DataXujing/SpotM2-Jetson/deepsocial/Images/SocialD-Violations.jpg

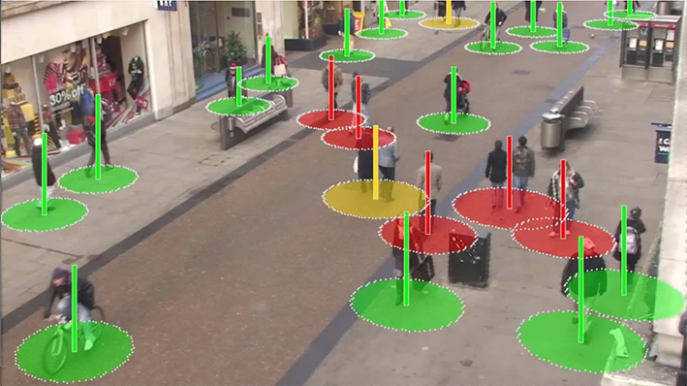
deepsocial/Images/SocialD-Violations.jpg
