DataXujing/SpotM2-Jetson/deepsocial/res/1bea7482696f88c633229da7782a3c09.jpeg

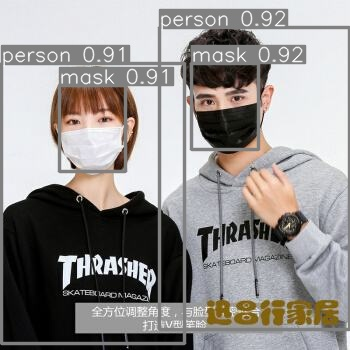
deepsocial/res/1bea7482696f88c633229da7782a3c09.jpeg
