DataXujing/SpotM2-Jetson/deepsocial/res/1e55ca499b109a8f58c59cec6625aa7d.jpeg

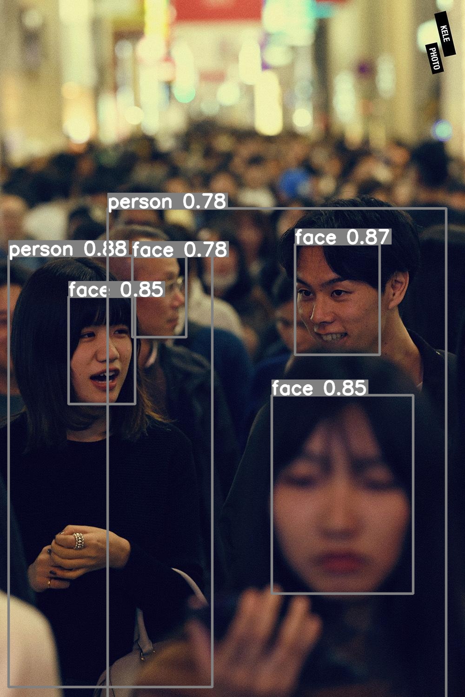
deepsocial/res/1e55ca499b109a8f58c59cec6625aa7d.jpeg
