DataXujing/SpotM2-Jetson/deepsocial/res/6f58421a69d5621d284e0617fe9576cd.jpeg

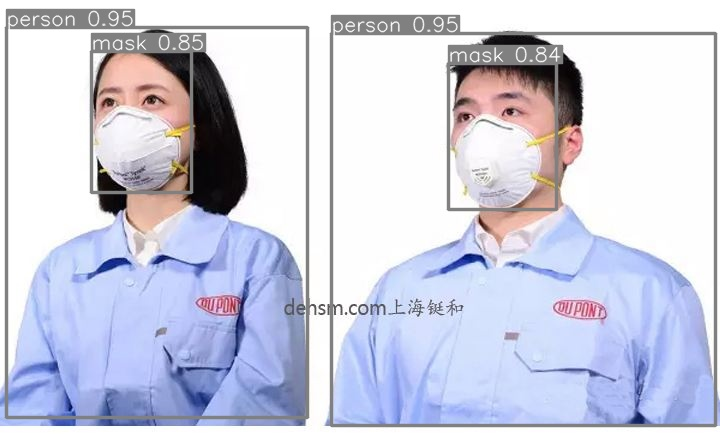
deepsocial/res/6f58421a69d5621d284e0617fe9576cd.jpeg
