DataXujing/SpotM2-Jetson/deepsocial/res/76a0da085213dce2dc654bfbd03b5c2e.jpeg

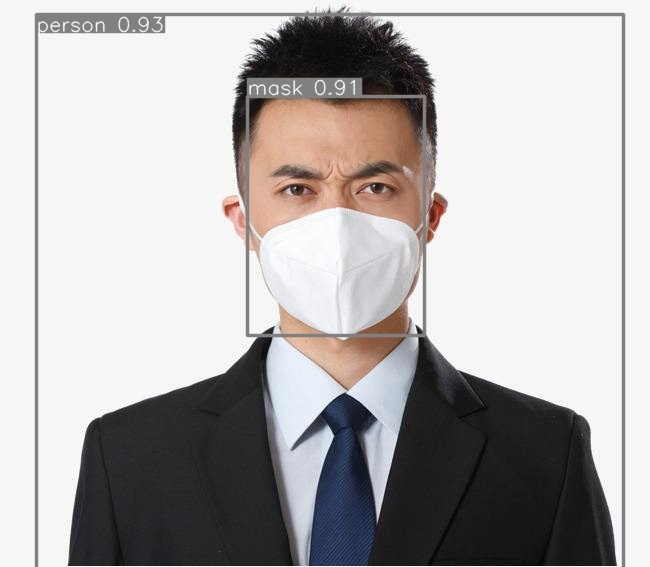
deepsocial/res/76a0da085213dce2dc654bfbd03b5c2e.jpeg
