DataXujing/SpotM2-Jetson/deepsocial/res/86e3ae728b26306a236e1a8555faf9d6.jpeg

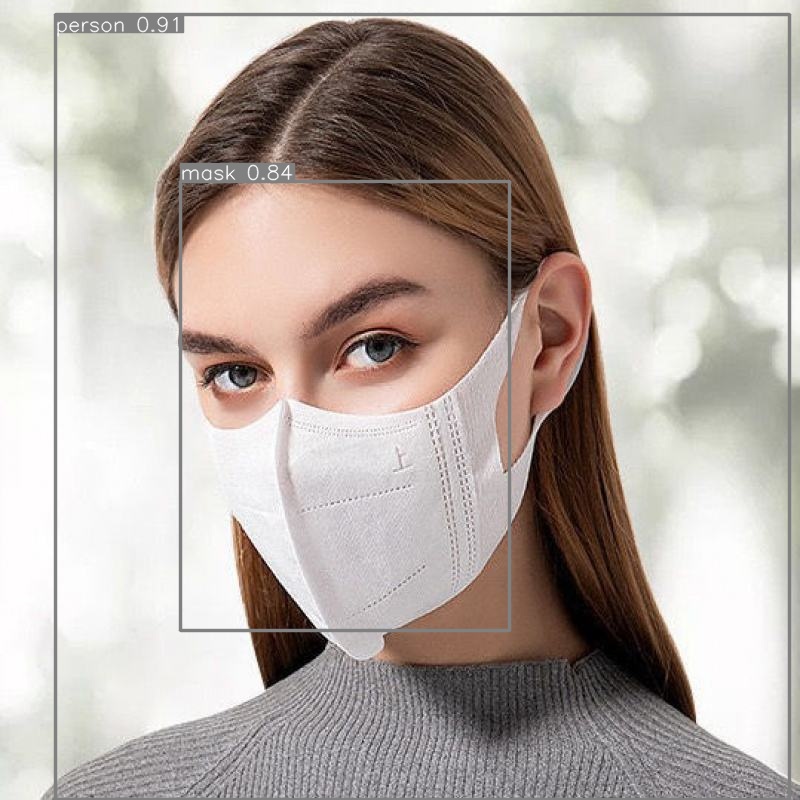
deepsocial/res/86e3ae728b26306a236e1a8555faf9d6.jpeg
