DataXujing/SpotM2-Jetson/deepsocial/res/359fc1ad313070030813128c69b127fc.jpeg

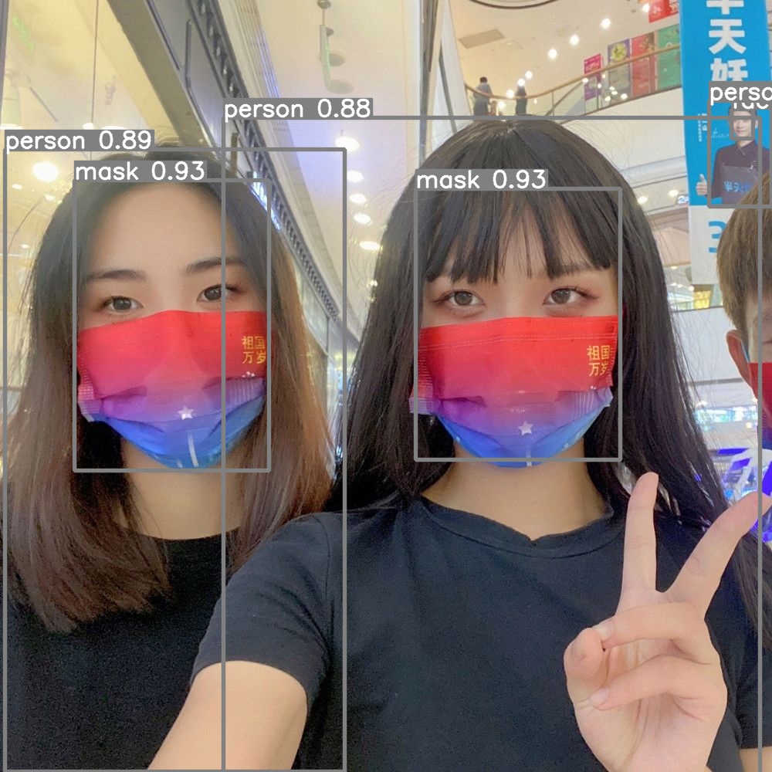
deepsocial/res/359fc1ad313070030813128c69b127fc.jpeg
