DataXujing/SpotM2-Jetson/deepsocial/res/64659bd6bf9b24c7b2e83b52e51c632e.jpeg

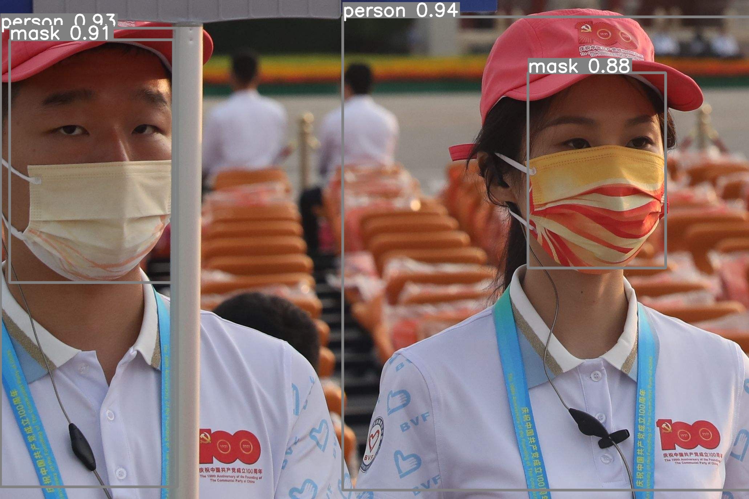
deepsocial/res/64659bd6bf9b24c7b2e83b52e51c632e.jpeg
