DataXujing/SpotM2-Jetson/deepsocial/res/a19aeec65c8fa7fa5cd013690f805bf3.jpeg

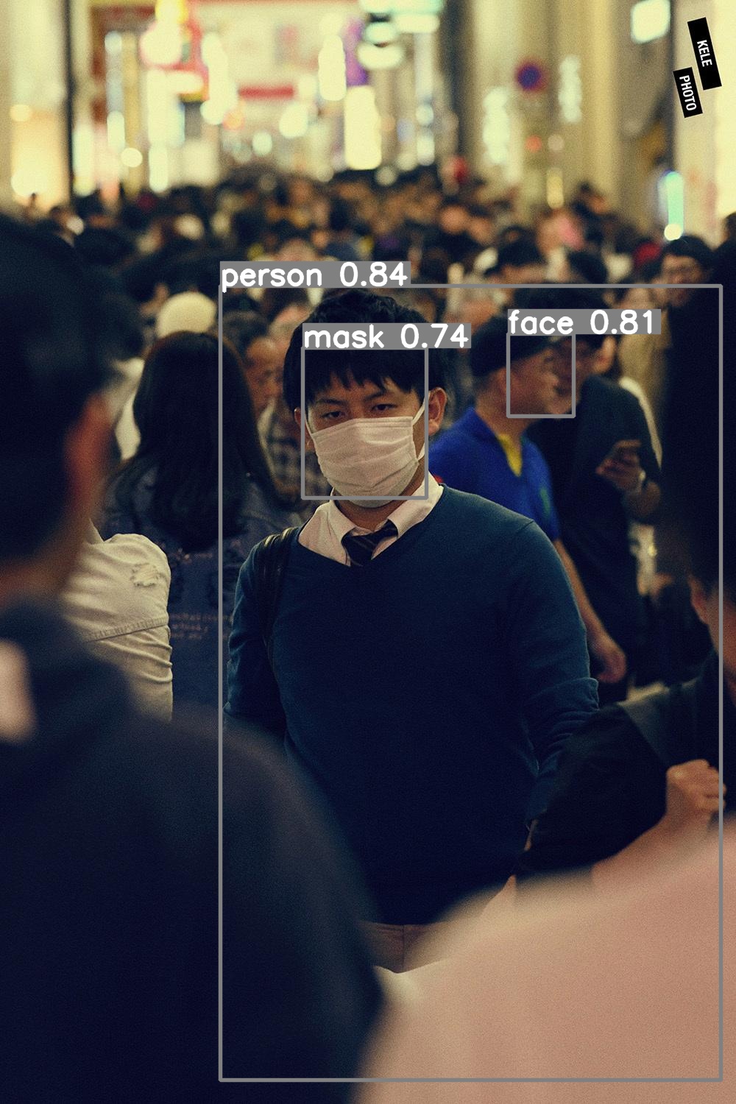
deepsocial/res/a19aeec65c8fa7fa5cd013690f805bf3.jpeg
