DataXujing/SpotM2-Jetson/deepsocial/res/b801af663609ed3e3a4c4865d9339148.jpeg

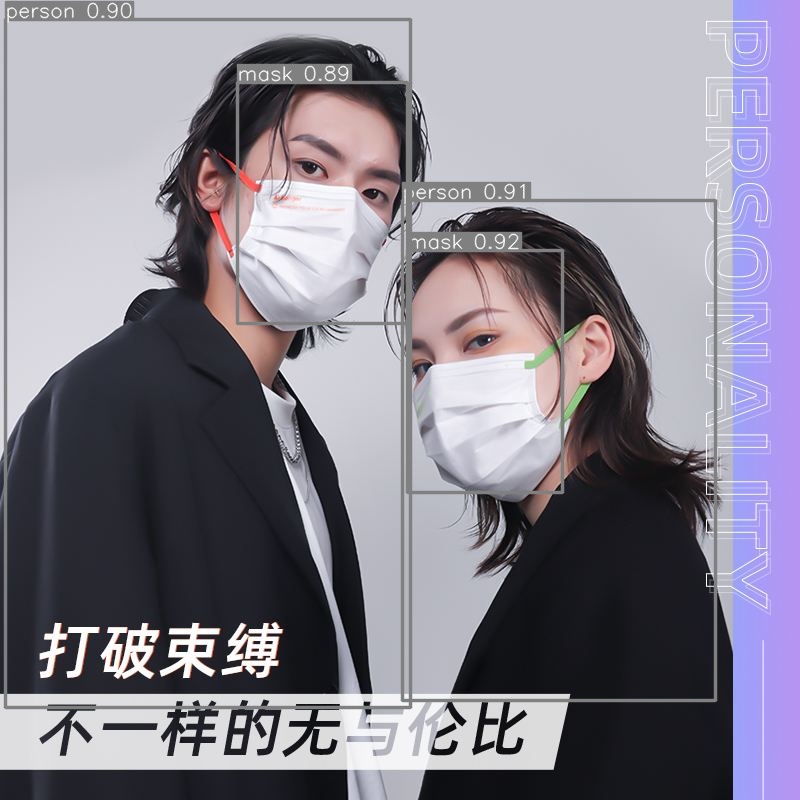
deepsocial/res/b801af663609ed3e3a4c4865d9339148.jpeg
