DataXujing/SpotM2-Jetson/deepsocial/res/d9d2d3555ee87a75234beef27a00c857.jpeg

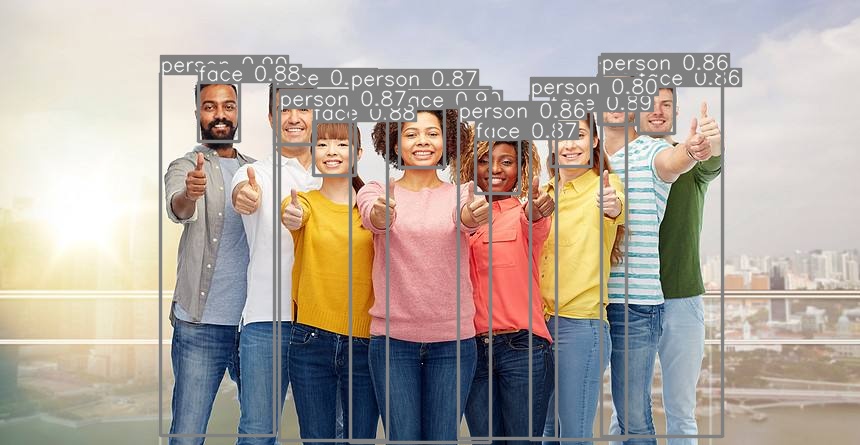
deepsocial/res/d9d2d3555ee87a75234beef27a00c857.jpeg
