DataXujing/SpotM2-Jetson/deepsocial/res/df1ec98a7be1bb21a3fbe03b773ce5f9.jpeg

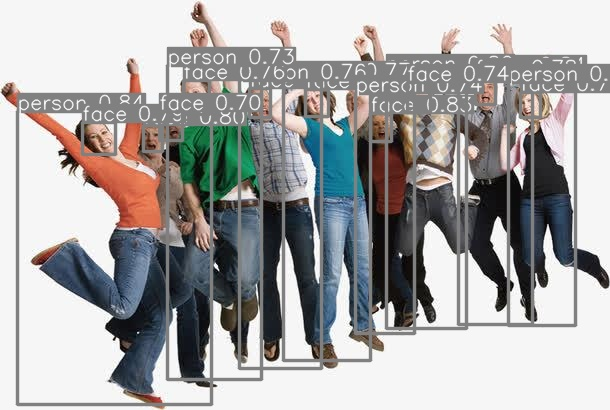
deepsocial/res/df1ec98a7be1bb21a3fbe03b773ce5f9.jpeg
