DataXujing/SpotM2-Jetson/deepsocial/res/e319a9496abcf98762bcb039ad041695.jpeg

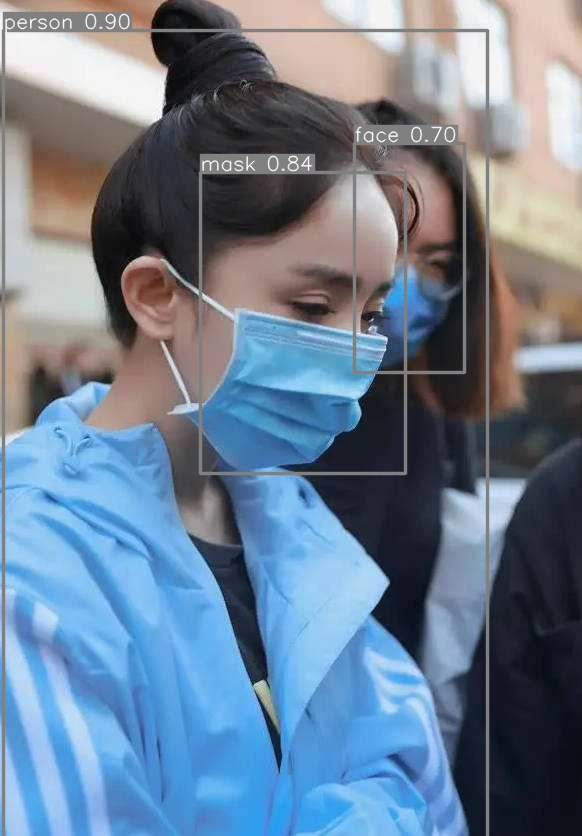
deepsocial/res/e319a9496abcf98762bcb039ad041695.jpeg
