DataXujing/SpotM2-Jetson/deepsocial/res/ed89a410d687e686057929587740cf3d.jpeg

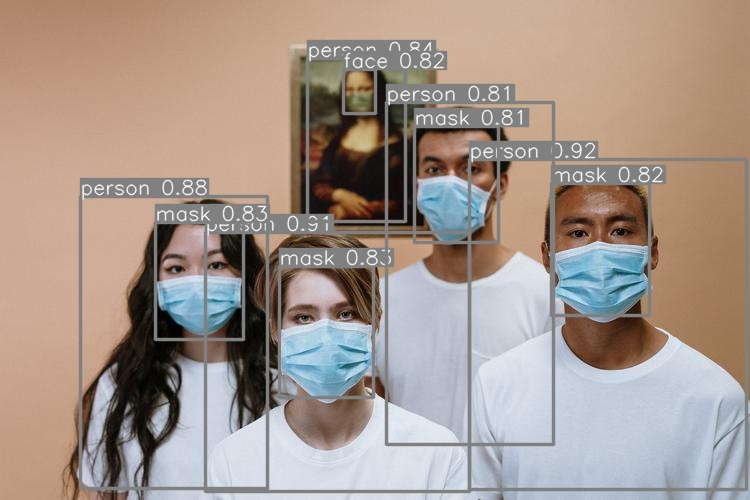
deepsocial/res/ed89a410d687e686057929587740cf3d.jpeg
