DataXujing/SpotM2-Jetson/deepsocial/res/f4e598c1ad9aae733f02a17c55224ddc.jpeg

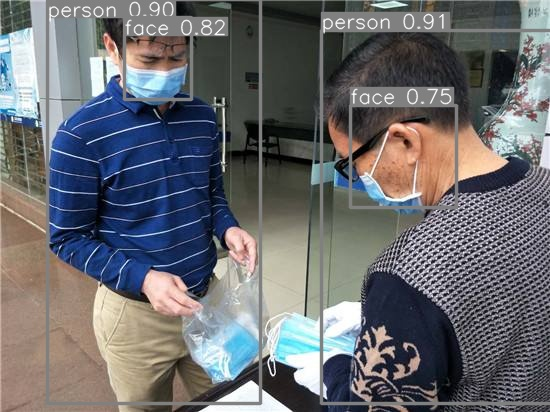
deepsocial/res/f4e598c1ad9aae733f02a17c55224ddc.jpeg
