DataXujing/SpotM2-Jetson/images/be20a860d1abb6605677f61556a89ea.jpg

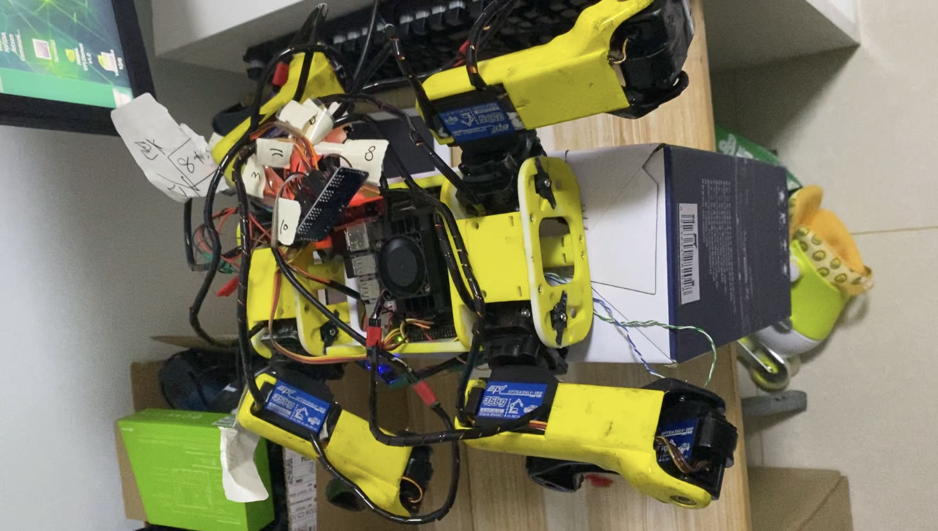
images/be20a860d1abb6605677f61556a89ea.jpg
