DataXujing/SpotM2-Jetson/spotMicro-ROS-Melodic-Jetson-Nano/assets/1_robot_right_links.png

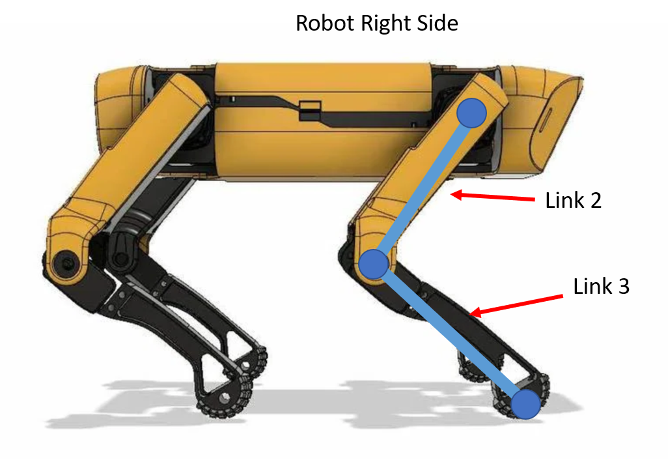
spotMicro-ROS-Melodic-Jetson-Nano/assets/1_robot_right_links.png
