DataXujing/SpotM2-Jetson/spotMicro-ROS-Melodic-Jetson-Nano/assets/2_right_straight_links.png

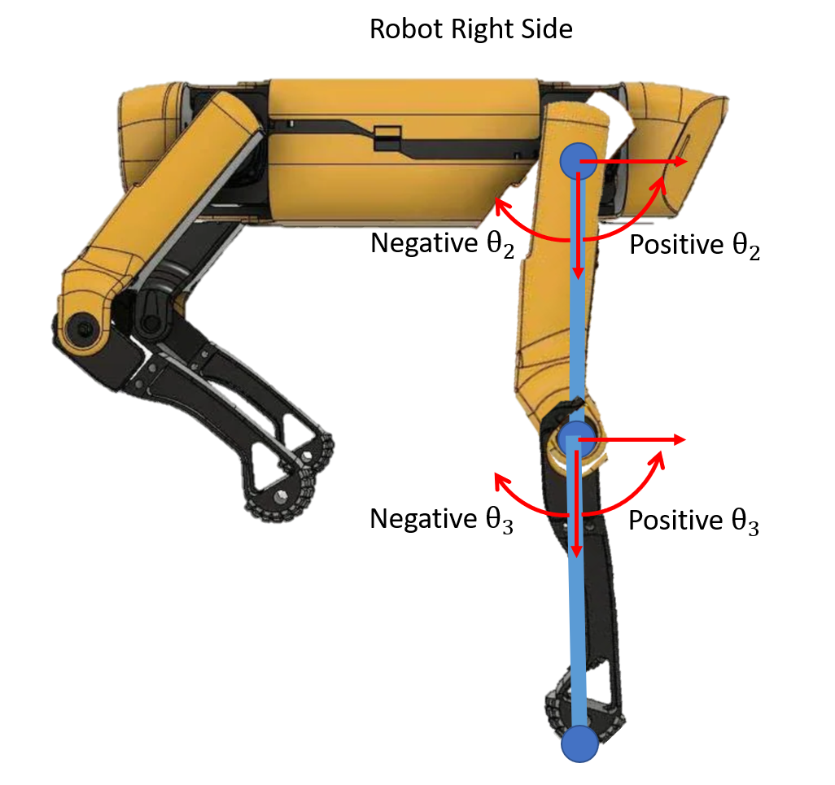
spotMicro-ROS-Melodic-Jetson-Nano/assets/2_right_straight_links.png
