DataXujing/SpotM2-Jetson/spotMicro-ROS-Melodic-Jetson-Nano/assets/3_right_link_angles_example.png

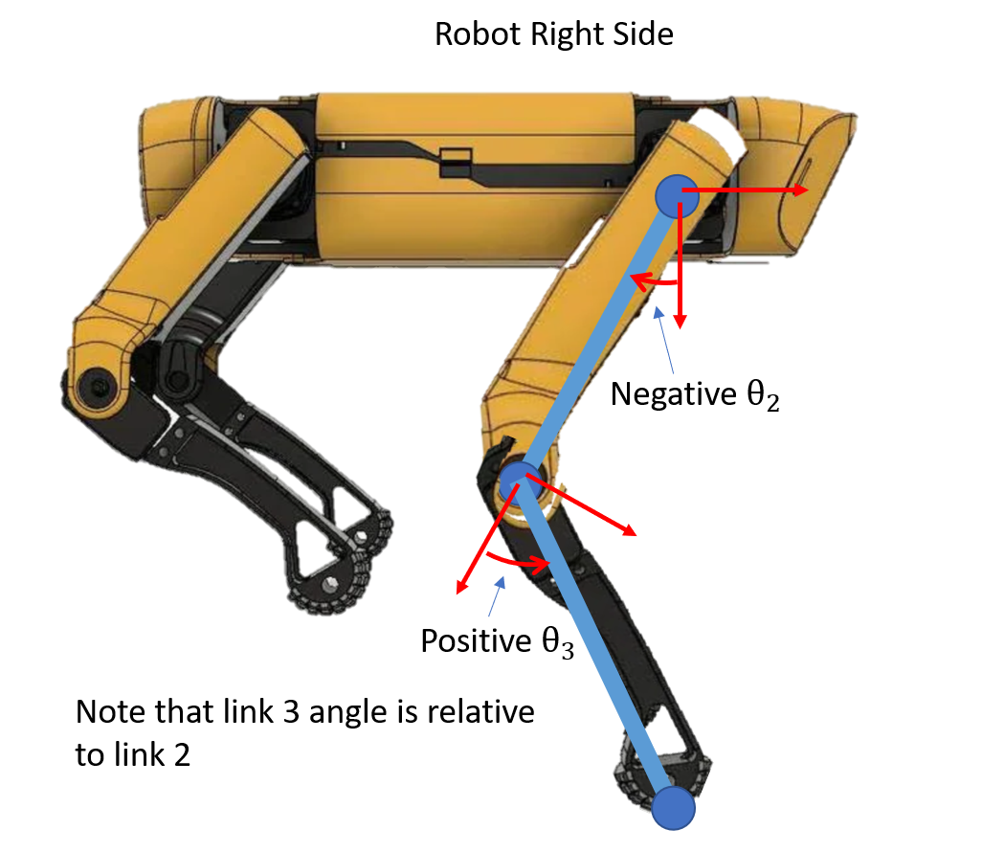
spotMicro-ROS-Melodic-Jetson-Nano/assets/3_right_link_angles_example.png
