DataXujing/SpotM2-Jetson/spotMicro-ROS-Melodic-Jetson-Nano/assets/7_robot_left_overview.png

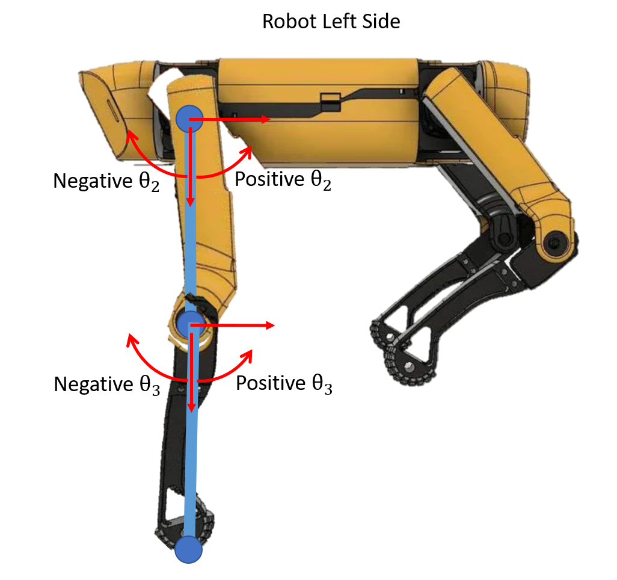
spotMicro-ROS-Melodic-Jetson-Nano/assets/7_robot_left_overview.png
