DataXujing/SpotM2-Jetson/spotMicro-ROS-Melodic-Jetson-Nano/assets/12_robot_back_overview.png

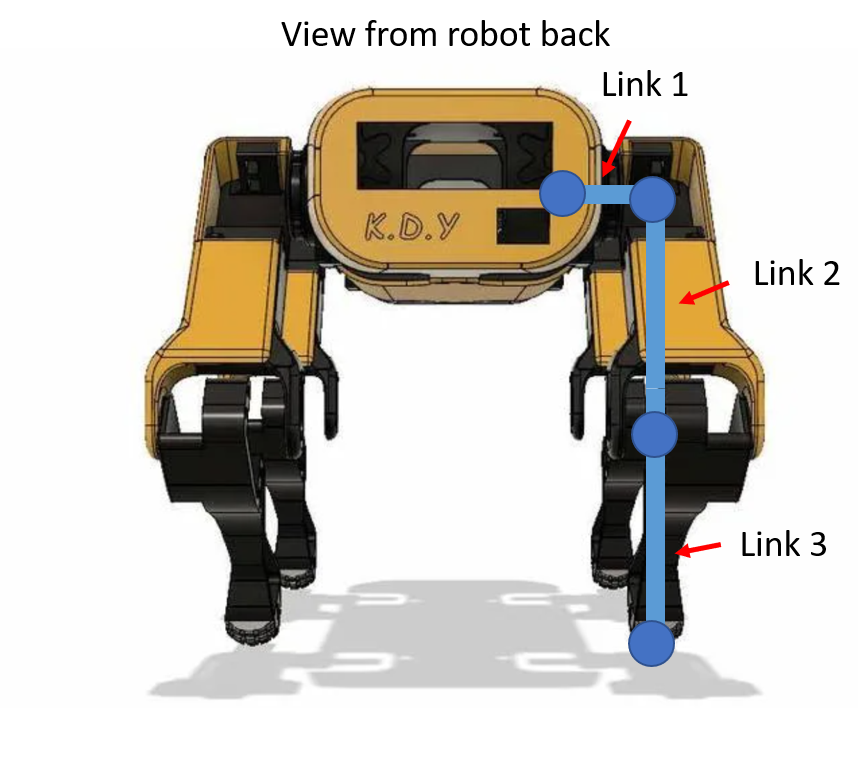
spotMicro-ROS-Melodic-Jetson-Nano/assets/12_robot_back_overview.png
