DataXujing/SpotM2-Jetson/spotMicro-ROS-Melodic-Jetson-Nano/assets/kinematic_coord_system.jpg

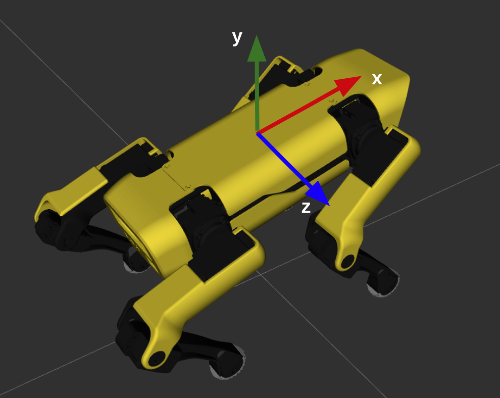
spotMicro-ROS-Melodic-Jetson-Nano/assets/kinematic_coord_system.jpg
