DataXujing/SpotM2-Jetson/spotMicro-ROS-Melodic-Jetson-Nano/assets/lidar_mount.jpg

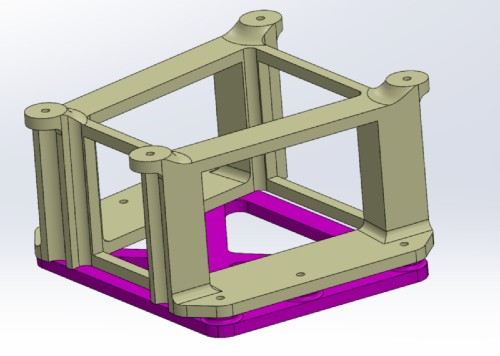
spotMicro-ROS-Melodic-Jetson-Nano/assets/lidar_mount.jpg
