DataXujing/SpotM2-Jetson/spotMicro-ROS-Melodic-Jetson-Nano/assets/robot_bottom.jpg

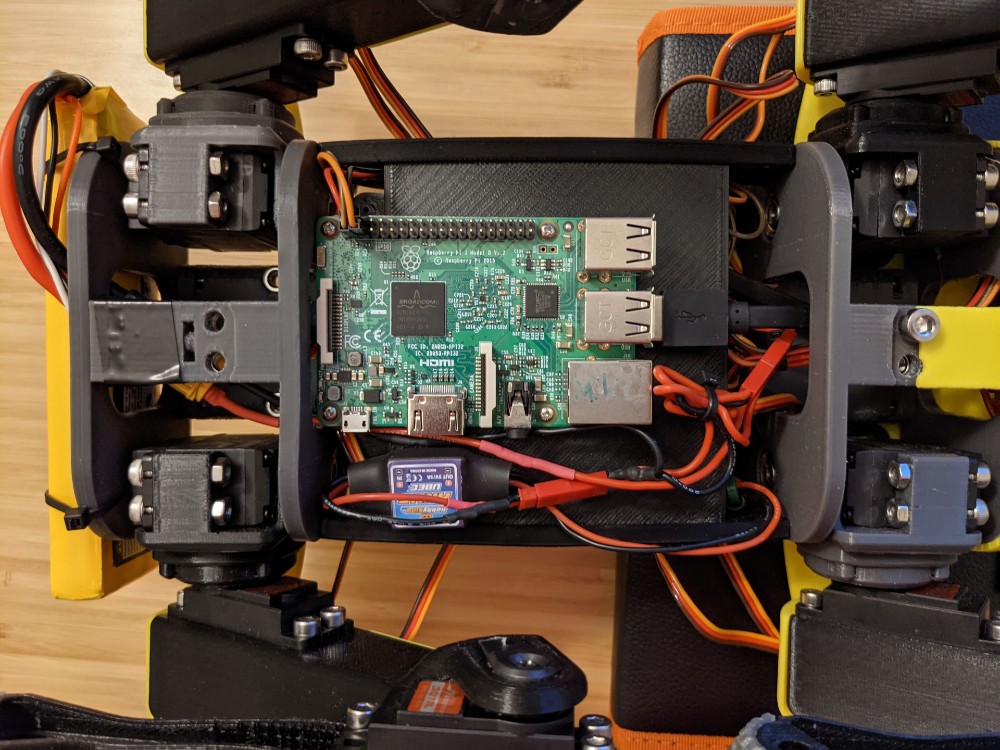
spotMicro-ROS-Melodic-Jetson-Nano/assets/robot_bottom.jpg
