DataXujing/SpotM2-Jetson/spotMicro-ROS-Melodic-Jetson-Nano/assets/robot_top.jpg

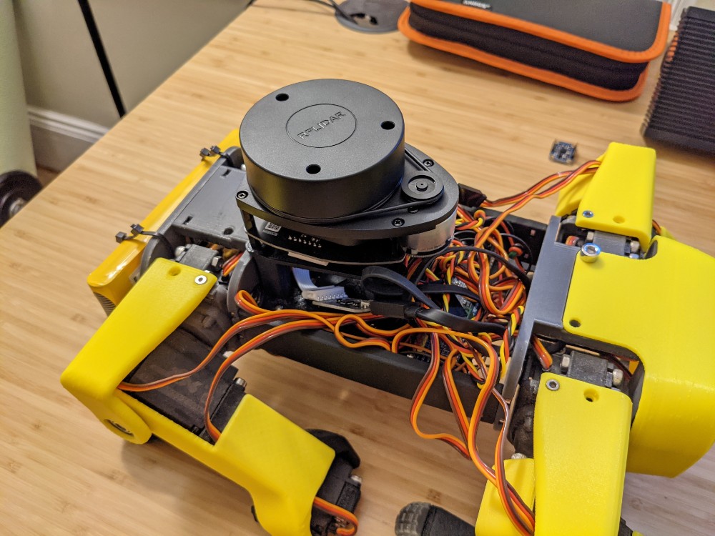
spotMicro-ROS-Melodic-Jetson-Nano/assets/robot_top.jpg
