DataXujing/SpotM2-Jetson/spotMicro-ROS-Melodic-Jetson-Nano/assets/robot_top_no_servos.jpg

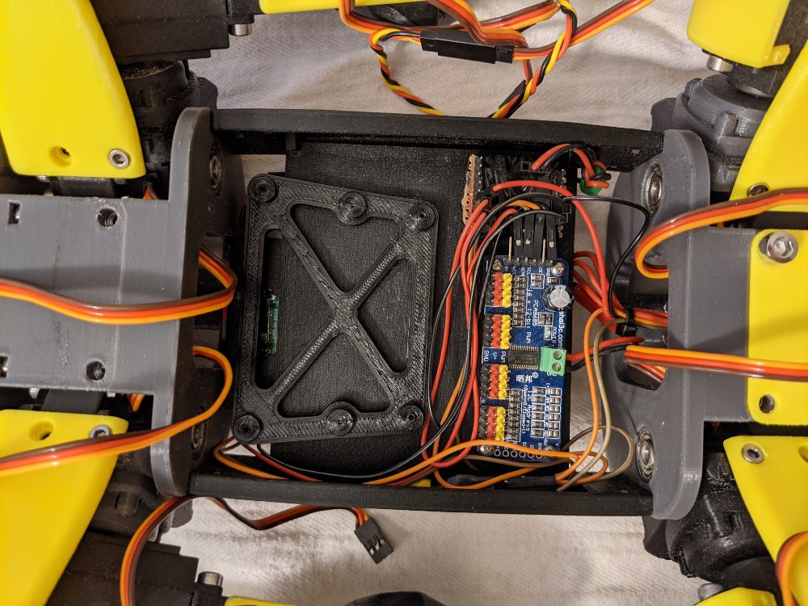
spotMicro-ROS-Melodic-Jetson-Nano/assets/robot_top_no_servos.jpg
