DataXujing/SpotM2-Jetson/spotMicro-ROS-Melodic-Jetson-Nano/assets/rpi_platform.jpg

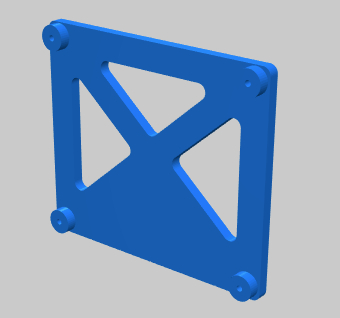
spotMicro-ROS-Melodic-Jetson-Nano/assets/rpi_platform.jpg
