DataXujing/SpotM2-Jetson/spotMicro-ROS-Melodic-Jetson-Nano/assets/rviz_animation.gif

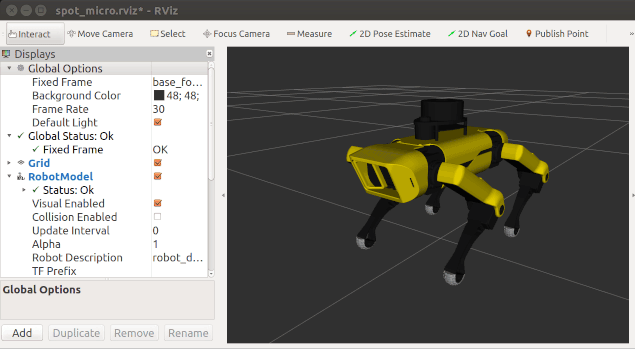
spotMicro-ROS-Melodic-Jetson-Nano/assets/rviz_animation.gif
