DataXujing/SpotM2-Jetson/spotMicro-ROS-Melodic-Jetson-Nano/assets/servo_move_prompt.png

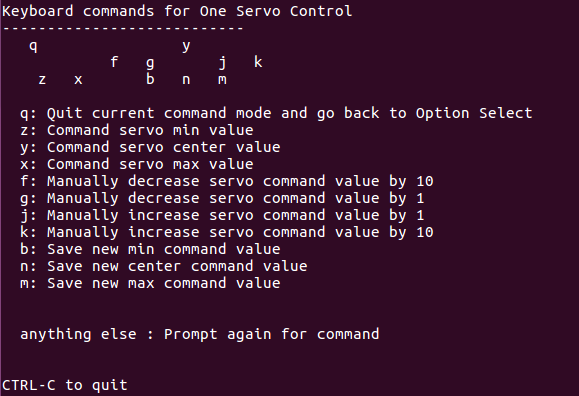
spotMicro-ROS-Melodic-Jetson-Nano/assets/servo_move_prompt.png
