DataXujing/SpotM2-Jetson/spotMicro-ROS-Melodic-Jetson-Nano/assets/spot_micro_slam.gif

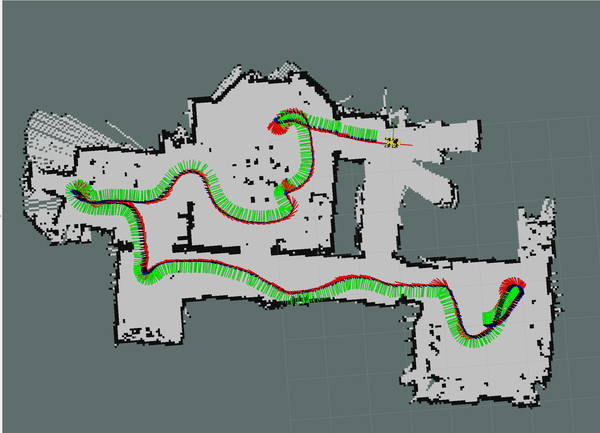
spotMicro-ROS-Melodic-Jetson-Nano/assets/spot_micro_slam.gif
