DataXujing/SpotM2-Jetson/spotMicro-ROS-Melodic-Jetson-Nano/assets/state_machine.png

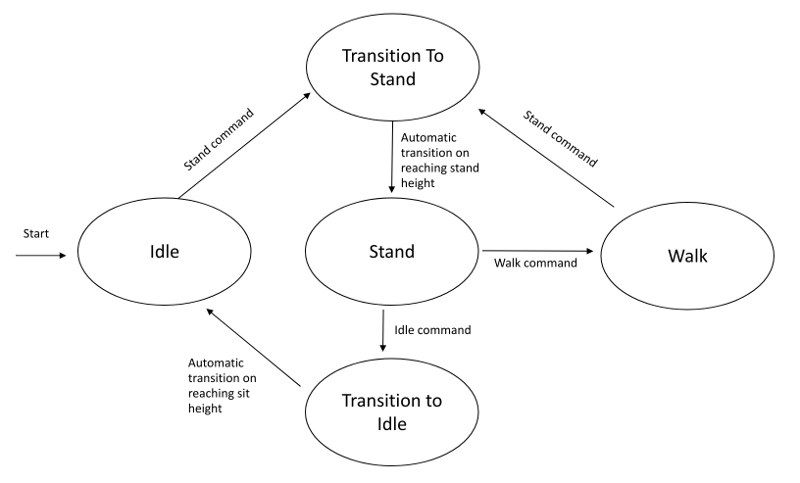
spotMicro-ROS-Melodic-Jetson-Nano/assets/state_machine.png
