DataXujing/SpotM2-Jetson/spotMicro-ROS-Melodic-Jetson-Nano/assets/tf2_coord_system.jpg

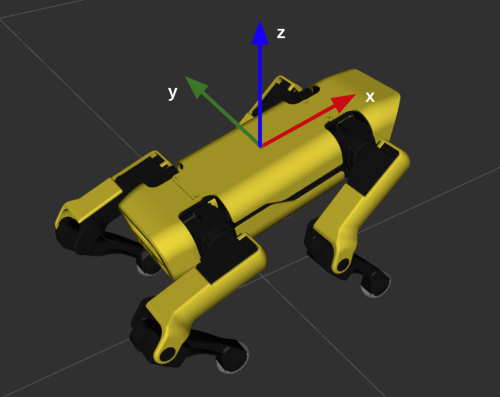
spotMicro-ROS-Melodic-Jetson-Nano/assets/tf2_coord_system.jpg
