DataXujing/SpotM2-Jetson/YOLOv6-mask/res/1e55ca499b109a8f58c59cec6625aa7d.jpeg

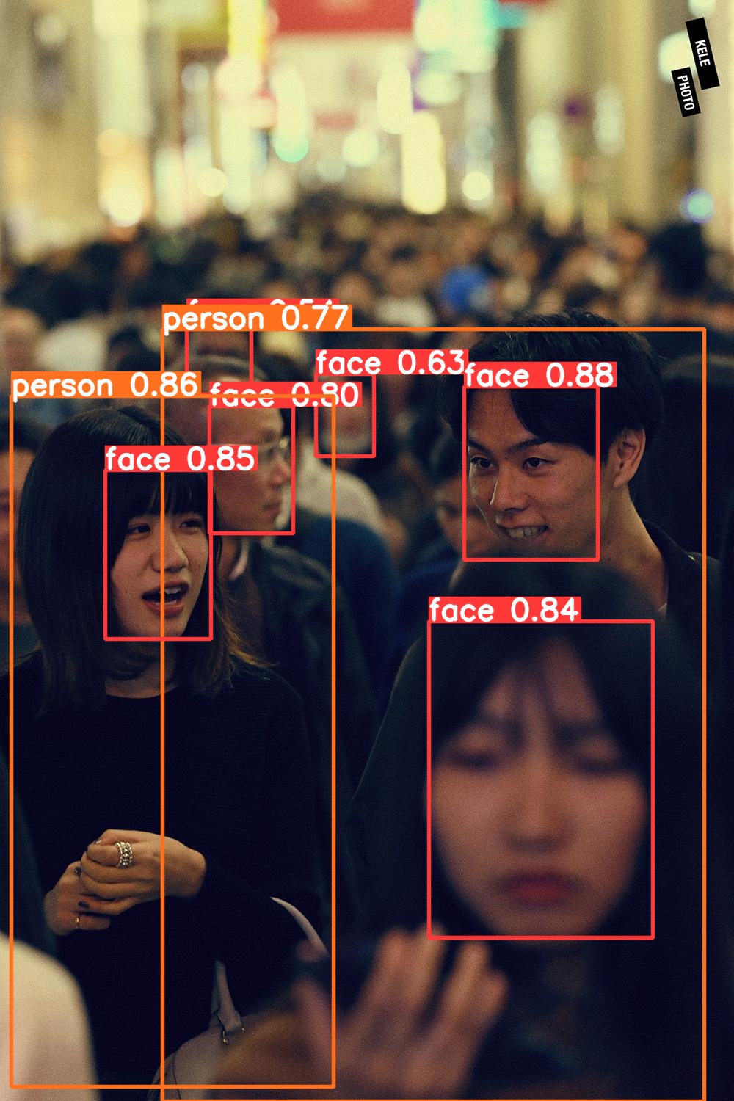
YOLOv6-mask/res/1e55ca499b109a8f58c59cec6625aa7d.jpeg
