DataXujing/SpotM2-Jetson/YOLOv6-mask/res/a19aeec65c8fa7fa5cd013690f805bf3.jpeg

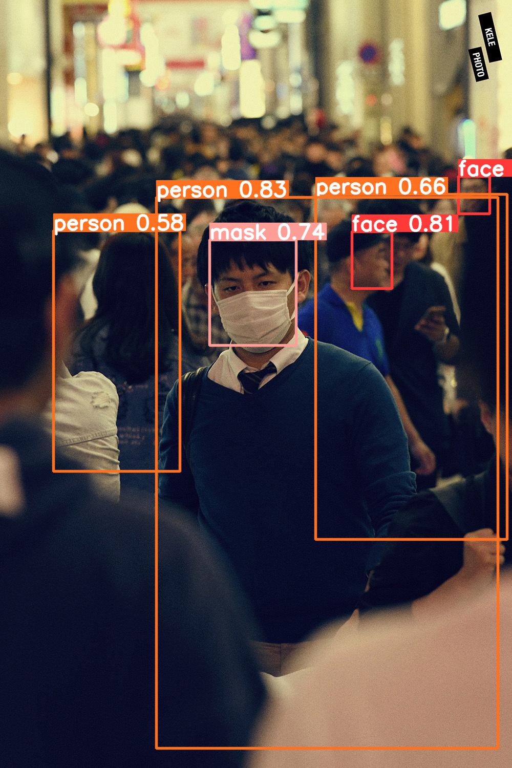
YOLOv6-mask/res/a19aeec65c8fa7fa5cd013690f805bf3.jpeg
