DataXujing/SpotM2-Jetson/YOLOv6-mask/res/d9d2d3555ee87a75234beef27a00c857.jpeg

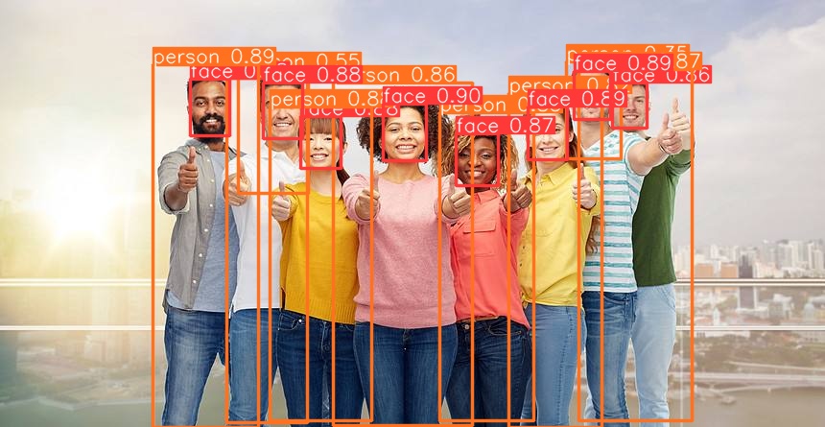
YOLOv6-mask/res/d9d2d3555ee87a75234beef27a00c857.jpeg
