DataXujing/SpotM2-Jetson/spotMicro-ROS-Melodic-Jetson-Nano/spot_micro_rviz/urdf/stl/mainbody.stl

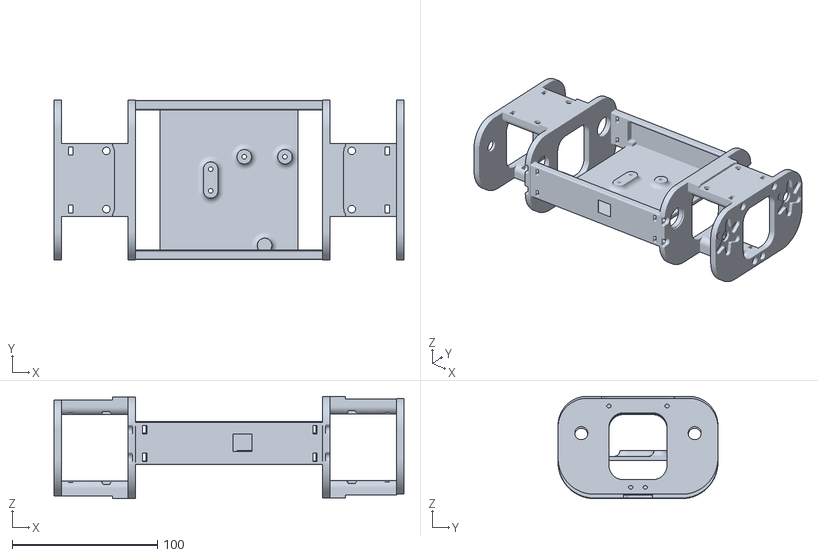
[picture p76: CAD file, 2022-12-09]
spotMicro-ROS-Melodic-Jetson-Nano/spot_micro_rviz/urdf/stl/mainbody.stl
240.7 x 110.0 x 70.4
