DataXujing/SpotM2-Jetson/spotMicro-ROS-Melodic-Jetson-Nano/spot_micro_rviz/urdf/stl/rplidar_main.STL

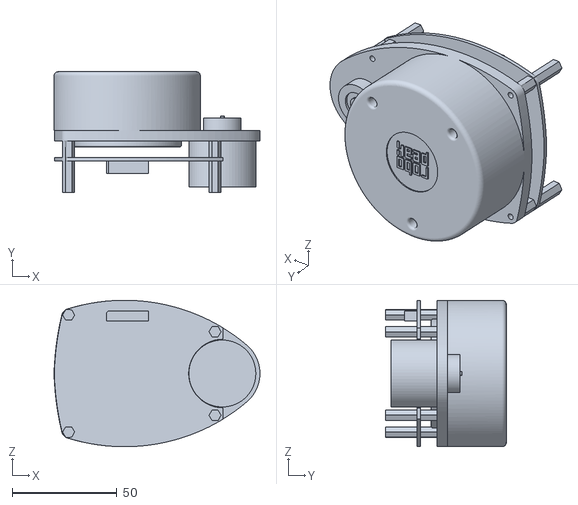
[picture p77: CAD file, 2022-12-09]
spotMicro-ROS-Melodic-Jetson-Nano/spot_micro_rviz/urdf/stl/rplidar_main.STL
98.5 x 57.7 x 70.0
