DataXujing/SpotM2-Jetson/3D打印件/各打1份/V1.02_Cover_Rear_Plain.stl

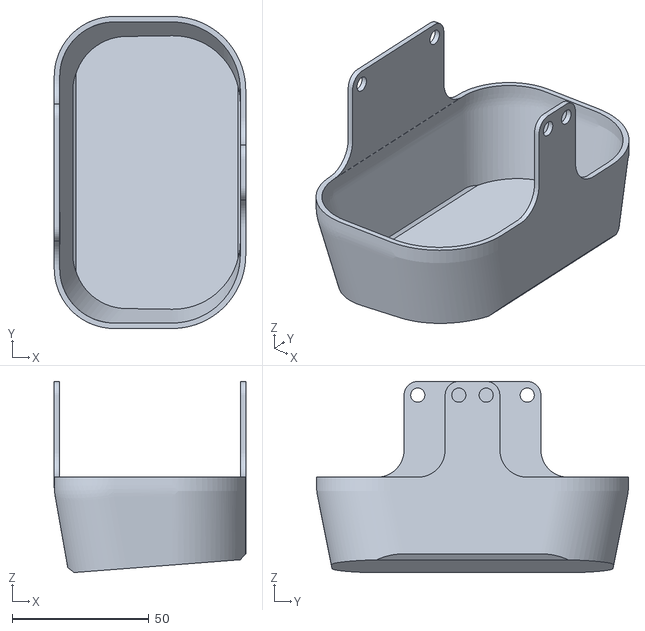
[picture p78: CAD file, 2022-12-09]
3D打印件/各打1份/V1.02_Cover_Rear_Plain.stl
70.0 x 114.0 x 69.8
