DataXujing/SpotM2-Jetson/3D打印件/各打2份/V1.02_Foot.stl

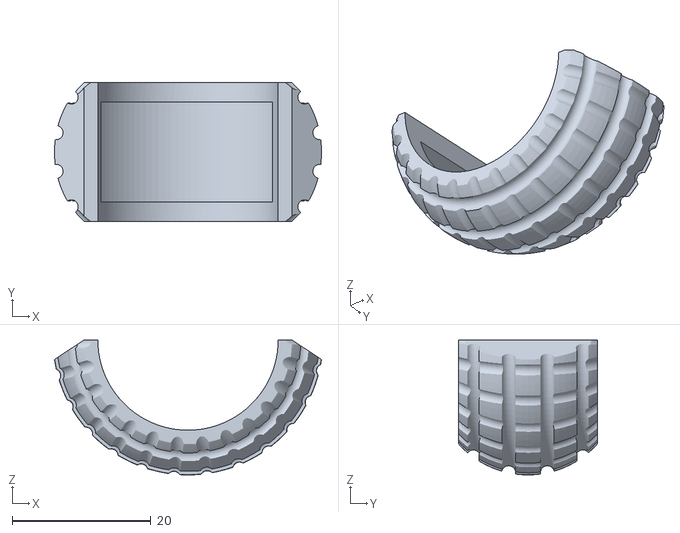
[picture p79: CAD file, 2022-12-09]
3D打印件/各打2份/V1.02_Foot.stl
38.5 x 20.0 x 19.4
