DataXujing/SpotM2-Jetson/spotMicro-ROS-Melodic-Jetson-Nano/spot_micro_rviz/urdf/stl/lshoulder.stl

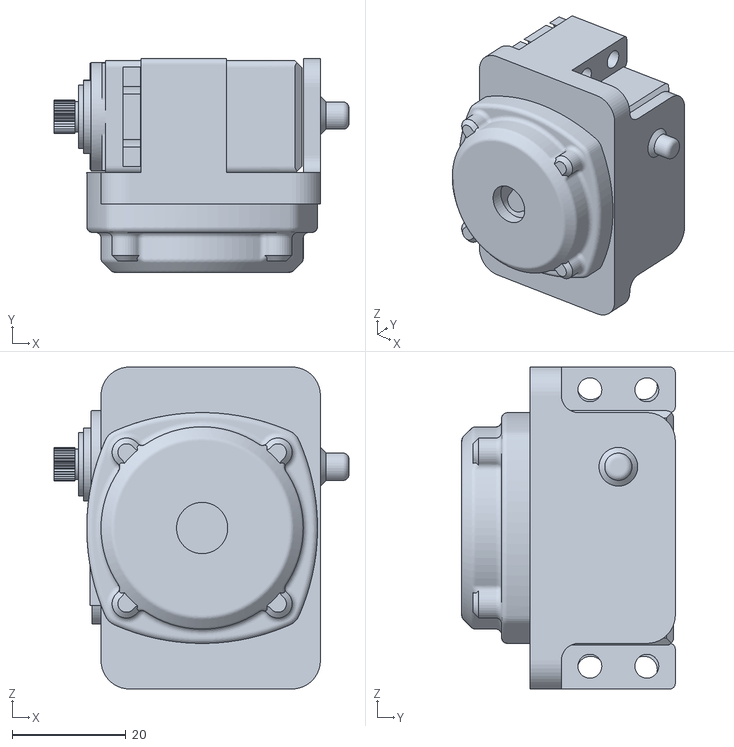
[picture p80: CAD file, 2022-12-09]
spotMicro-ROS-Melodic-Jetson-Nano/spot_micro_rviz/urdf/stl/lshoulder.stl
51.7 x 37.5 x 56.5
