DataXujing/SpotM2-Jetson/3D打印件/各打1份/V1.02_Rear_Outer_Shoulder.stl

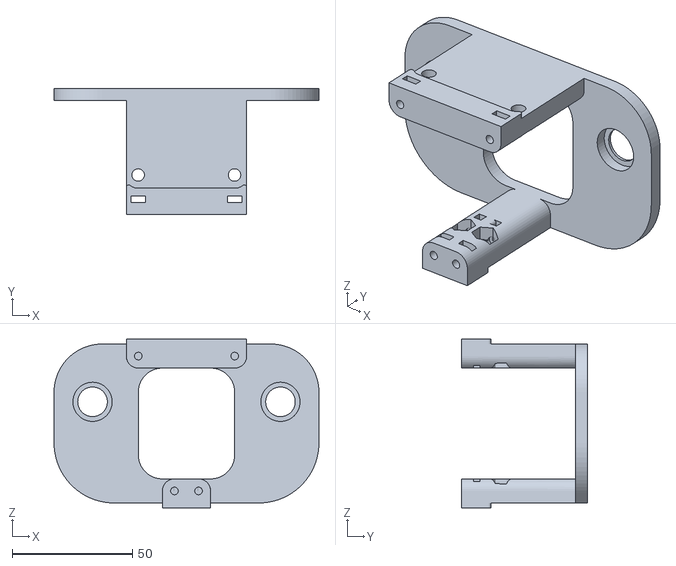
[picture p81: CAD file, 2022-12-09]
3D打印件/各打1份/V1.02_Rear_Outer_Shoulder.stl
110.0 x 52.5 x 70.0
