DataXujing/SpotM2-Jetson/spotMicro-ROS-Melodic-Jetson-Nano/spot_micro_rviz/urdf/stl/rfoot.stl

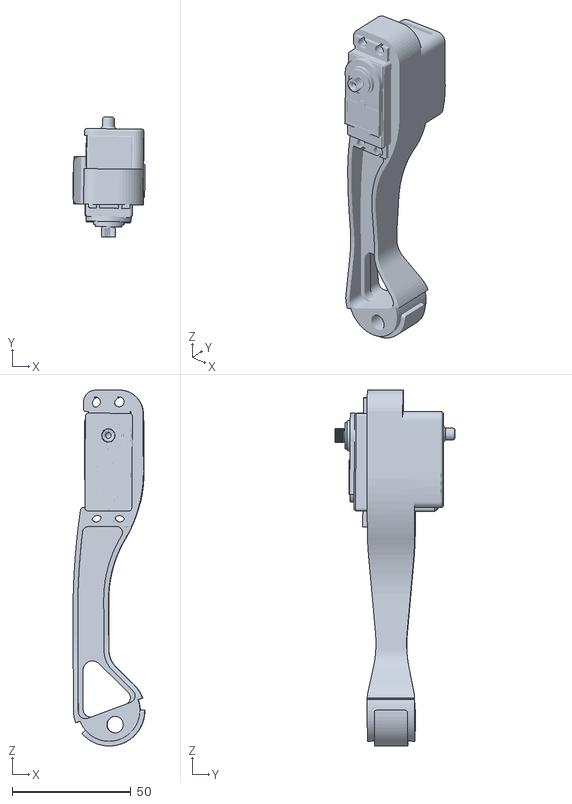
[picture p82: CAD file, 2022-12-09]
spotMicro-ROS-Melodic-Jetson-Nano/spot_micro_rviz/urdf/stl/rfoot.stl
30.4 x 50.7 x 150.0
