DataXujing/SpotM2-Jetson/3D打印件/各打1份/V1.02_Rear_Inner_Shoulder.stl

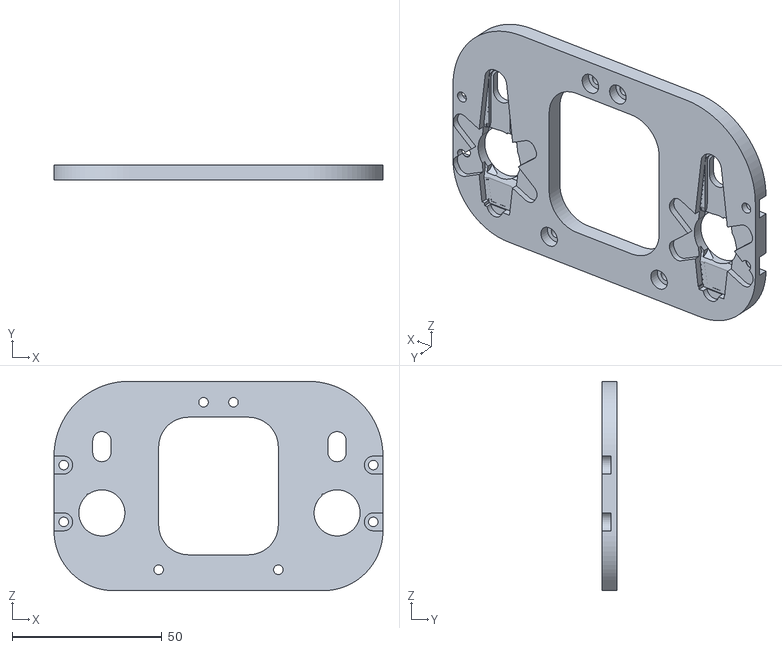
[picture p83: CAD file, 2022-12-09]
3D打印件/各打1份/V1.02_Rear_Inner_Shoulder.stl
110.0 x 5.00 x 70.0
