DataXujing/SpotM2-Jetson/3D打印件/各打2份/V1.02_Left_MidLimb.stl

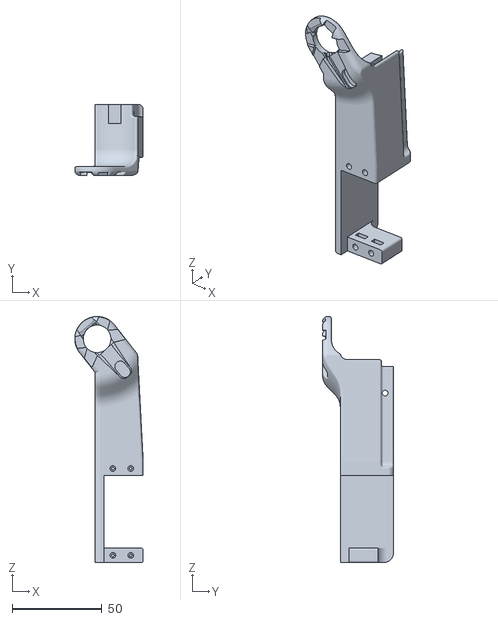
[picture p84: CAD file, 2022-12-09]
3D打印件/各打2份/V1.02_Left_MidLimb.stl
38.2 x 39.8 x 137.4
