DataXujing/SpotM2-Jetson/spotMicro-ROS-Melodic-Jetson-Nano/spot_micro_rviz/urdf/stl/larm_cover.stl

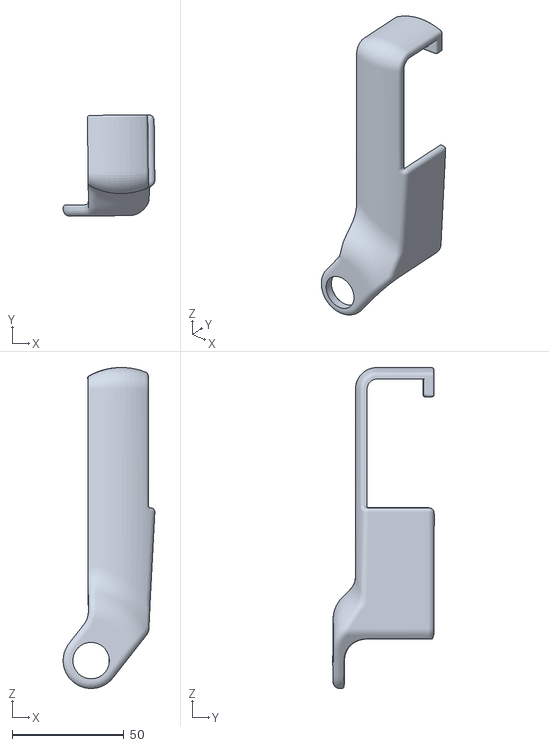
[picture p85: CAD file, 2022-12-09]
spotMicro-ROS-Melodic-Jetson-Nano/spot_micro_rviz/urdf/stl/larm_cover.stl
41.0 x 45.4 x 143.5
