DataXujing/SpotM2-Jetson/3D打印件/各打1份/V1.02_Cover_Top.stl

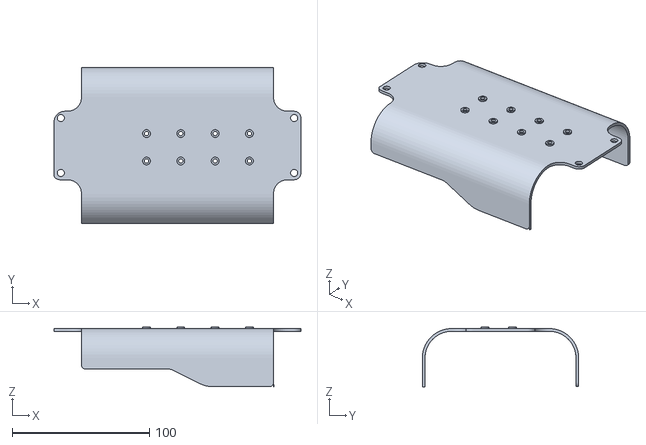
[picture p86: CAD file, 2022-12-09]
3D打印件/各打1份/V1.02_Cover_Top.stl
180.0 x 114.0 x 43.5
