DataXujing/SpotM2-Jetson/3D打印件/各打2份/V1.02_Right_MidLimb_Cover.stl

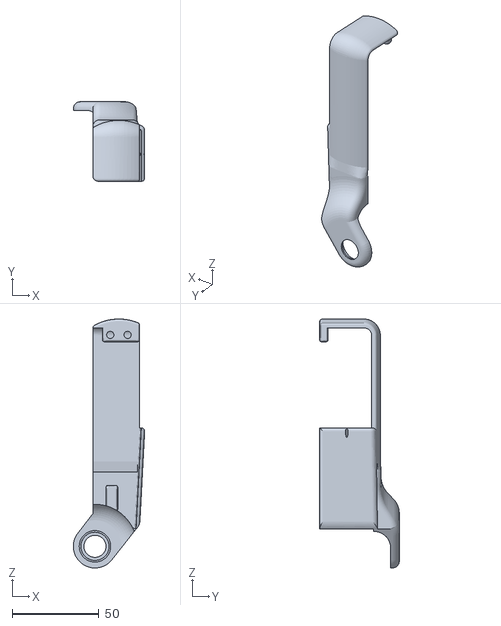
[picture p87: CAD file, 2022-12-09]
3D打印件/各打2份/V1.02_Right_MidLimb_Cover.stl
41.1 x 45.9 x 143.6
