DataXujing/SpotM2-Jetson/3D打印件/各打1份/V1.02_Cover_Nose.stl

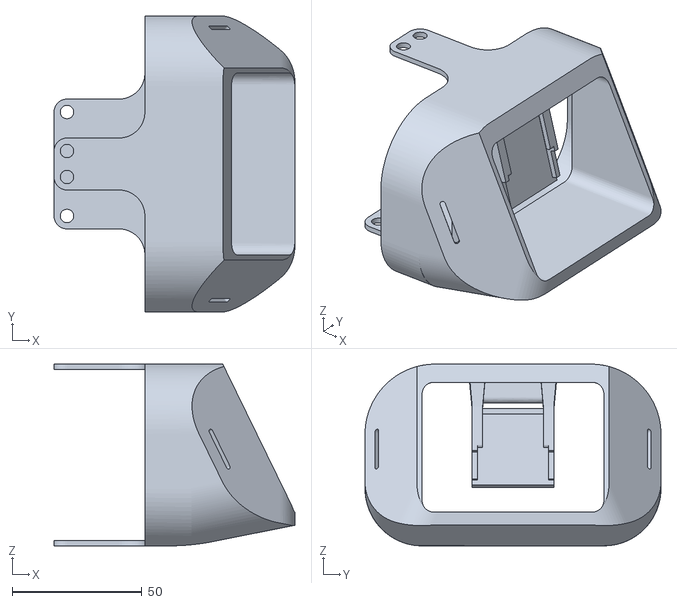
[picture p91: CAD file, 2022-12-09]
3D打印件/各打1份/V1.02_Cover_Nose.stl
92.8 x 114.0 x 70.0
