DataXujing/SpotM2-Jetson/3D打印件/各打2份/V1.02_Right_Wrist.stl

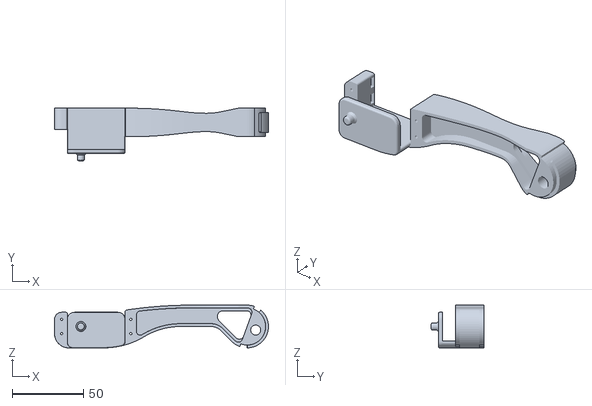
[picture p92: CAD file, 2022-12-09]
3D打印件/各打2份/V1.02_Right_Wrist.stl
150.0 x 36.9 x 30.0
