DataXujing/SpotM2-Jetson/3D打印件/各打1份/V1.02_Chassis_Right_Side.stl

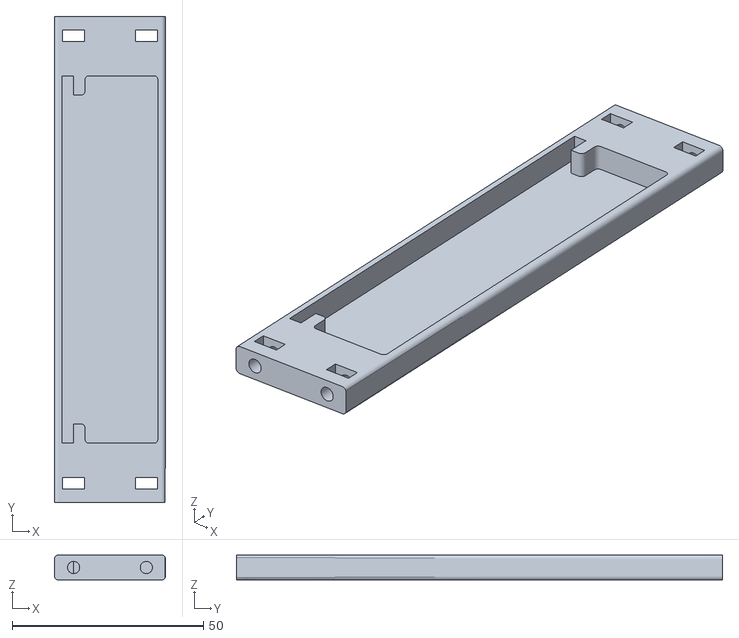
[picture p94: CAD file, 2022-12-09]
3D打印件/各打1份/V1.02_Chassis_Right_Side.stl
29.0 x 127.0 x 6.50
