DataXujing/SpotM2-Jetson/3D打印件/各打1份/V1.02_Cover_Bottom.stl

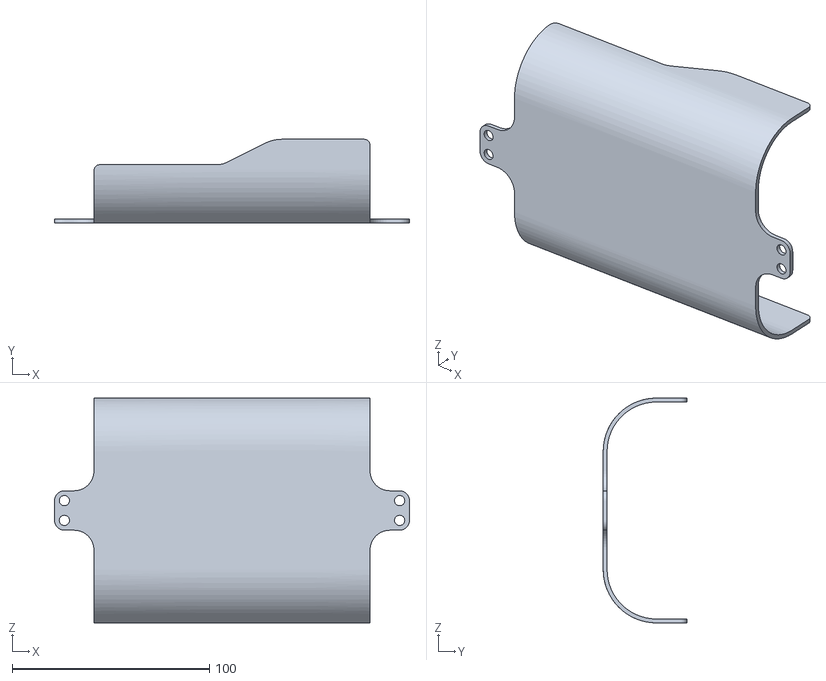
[picture p95: CAD file, 2022-12-09]
3D打印件/各打1份/V1.02_Cover_Bottom.stl
180.0 x 42.4 x 114.0
