DataXujing/SpotM2-Jetson/3D打印件/各打1份/V1.02_Chassis_BasePlate_RPi4.STL

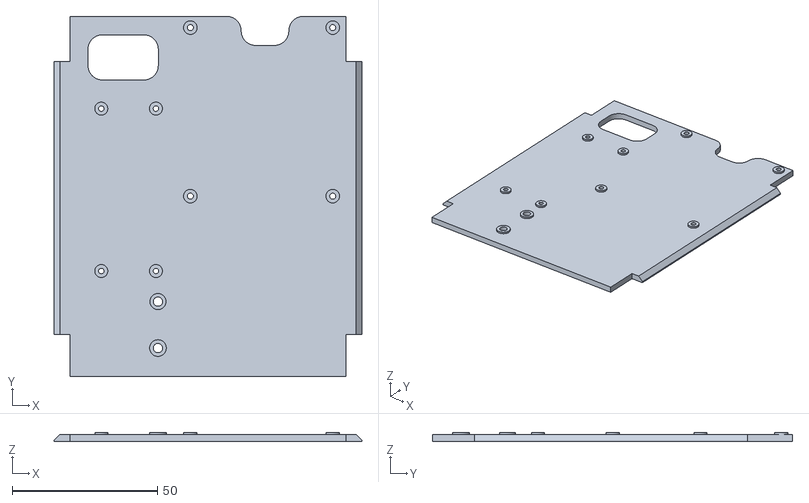
[picture p96: CAD file, 2022-12-09]
3D打印件/各打1份/V1.02_Chassis_BasePlate_RPi4.STL
106.0 x 124.0 x 3.22
