DataXujing/SpotM2-Jetson/3D打印件/各打2份/V1.02_Left_Hind_Limb.stl

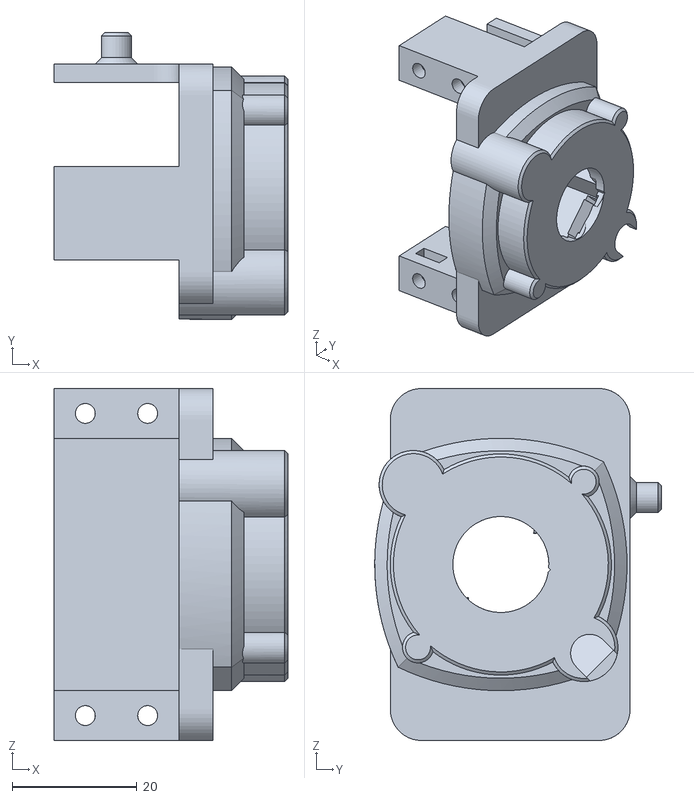
[picture p97: CAD file, 2022-12-09]
3D打印件/各打2份/V1.02_Left_Hind_Limb.stl
37.5 x 46.0 x 56.5
