DataXujing/SpotM2-Jetson/(list of files, cad)

Other CAD files:
3D打印件/各打2份/V1.02_Foot(Mirror).stl
spotMicro-ROS-Melodic-Jetson-Nano/spot_micro_rviz/urdf/stl/rarm_cover.stl
3D打印件/各打2份/V1.02_Right_MidLimb.stl
spotMicro-ROS-Melodic-Jetson-Nano/spot_micro_rviz/urdf/stl/rshoulder.stl
3D打印件/各打2份/V1.02_Left_Wrist.stl
spotMicro-ROS-Melodic-Jetson-Nano/spot_micro_rviz/urdf/stl/larm.stl
3D打印件/各打1份/V1.02_Chassis_Left_Side.stl
3D打印件/各打2份/V1.02_Left_MidLimb_Cover.stl
spotMicro-ROS-Melodic-Jetson-Nano/spot_micro_rviz/urdf/stl/lfoot.stl
spotMicro-ROS-Melodic-Jetson-Nano/spot_micro_rviz/urdf/stl/foot.stl
