DataXujing/SpotM2-Jetson/spotMicro-ROS-Melodic-Jetson-Nano/assets/4_right_link2_config_step_2.png

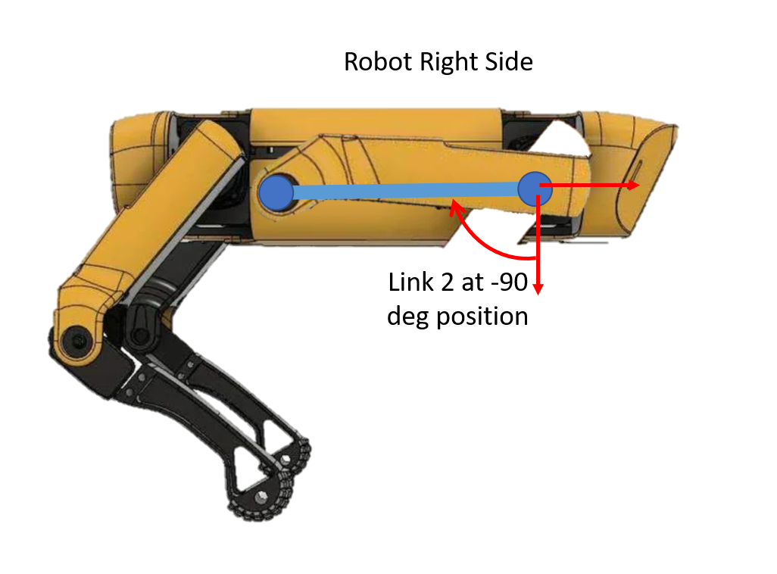
spotMicro-ROS-Melodic-Jetson-Nano/assets/4_right_link2_config_step_2.png
