DataXujing/SpotM2-Jetson/spotMicro-ROS-Melodic-Jetson-Nano/assets/5_right_link3_config_step_1.png

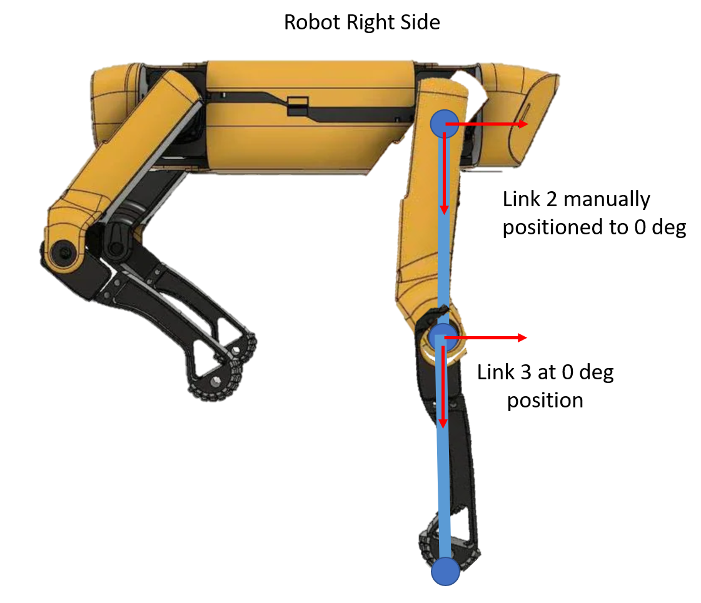
spotMicro-ROS-Melodic-Jetson-Nano/assets/5_right_link3_config_step_1.png
