DataXujing/SpotM2-Jetson/spotMicro-ROS-Melodic-Jetson-Nano/assets/6_right_link3_config_step_2.png

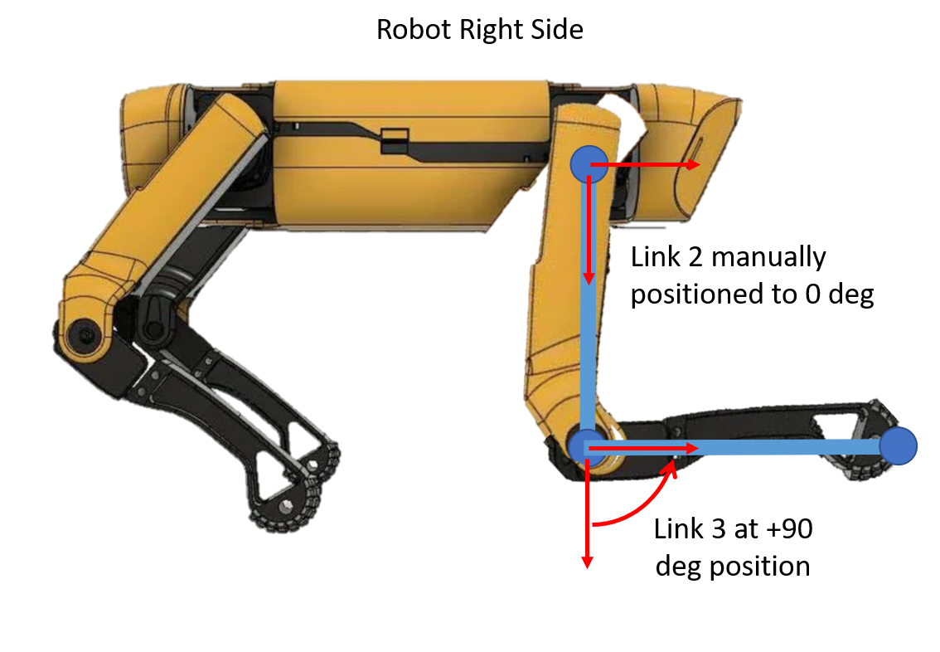
spotMicro-ROS-Melodic-Jetson-Nano/assets/6_right_link3_config_step_2.png
