DataXujing/SpotM2-Jetson/spotMicro-ROS-Melodic-Jetson-Nano/assets/8_left_link2_config_step_1.png

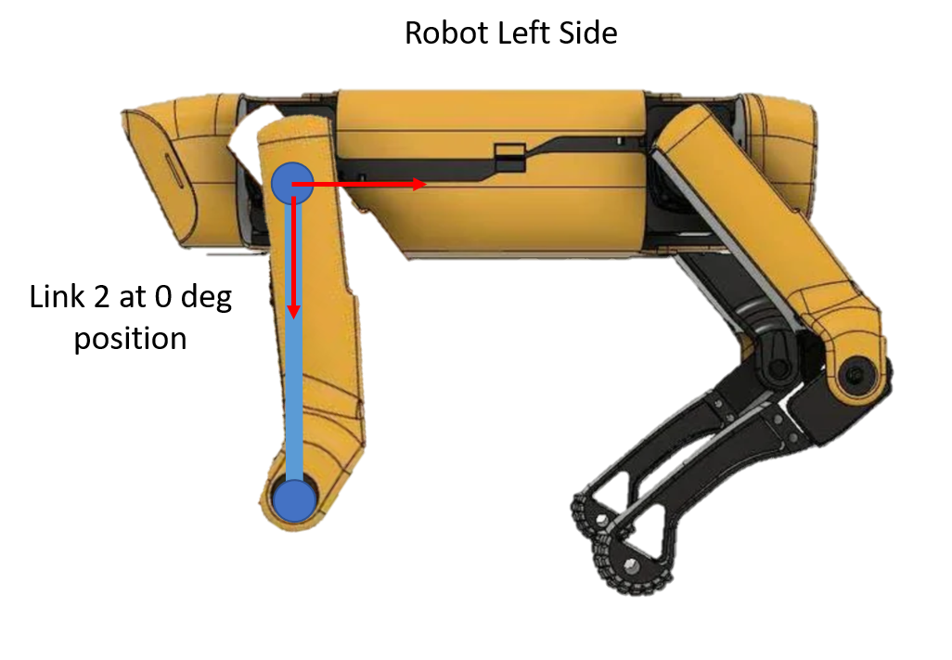
spotMicro-ROS-Melodic-Jetson-Nano/assets/8_left_link2_config_step_1.png
