DataXujing/SpotM2-Jetson/spotMicro-ROS-Melodic-Jetson-Nano/assets/9_left_link2_config_step_2.png

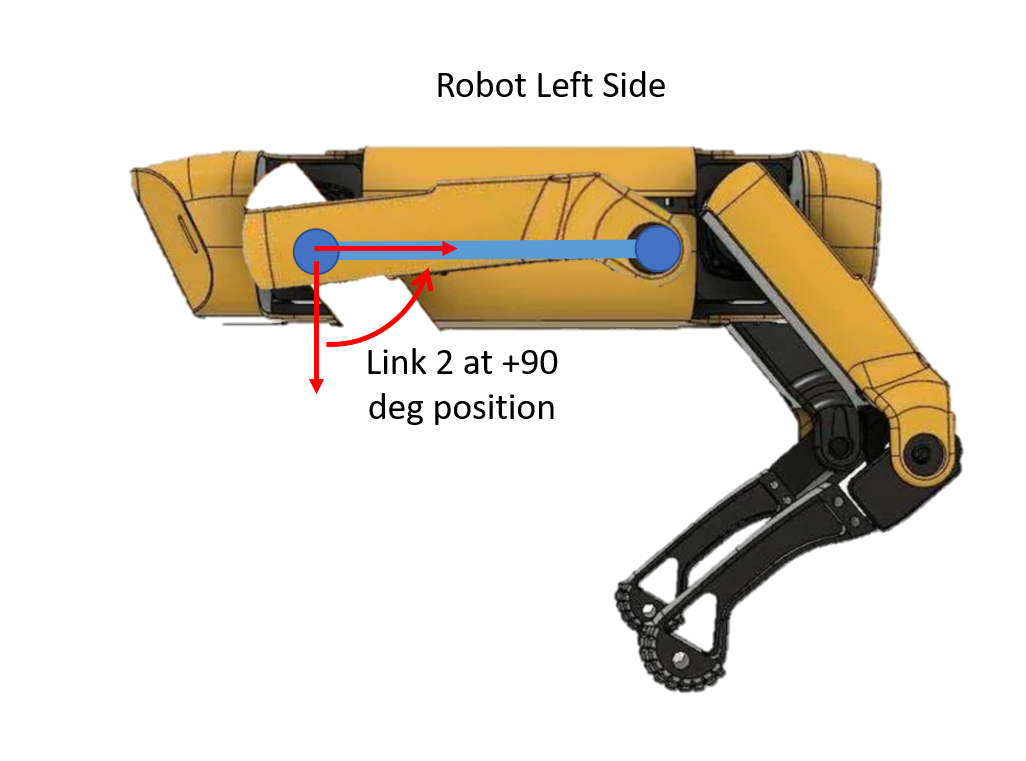
spotMicro-ROS-Melodic-Jetson-Nano/assets/9_left_link2_config_step_2.png
