DataXujing/SpotM2-Jetson/spotMicro-ROS-Melodic-Jetson-Nano/assets/10_left_link3_config_step_1.png

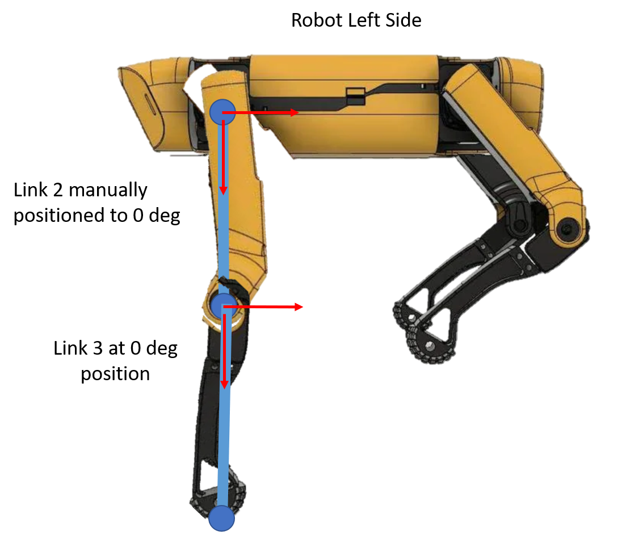
spotMicro-ROS-Melodic-Jetson-Nano/assets/10_left_link3_config_step_1.png
