DataXujing/SpotM2-Jetson/spotMicro-ROS-Melodic-Jetson-Nano/assets/14_right_link1_config_step_1.png

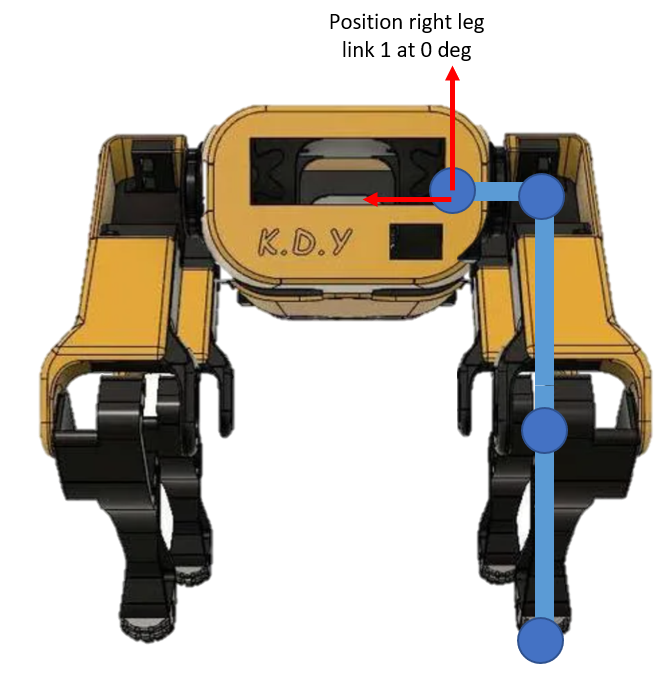
spotMicro-ROS-Melodic-Jetson-Nano/assets/14_right_link1_config_step_1.png
