DataXujing/SpotM2-Jetson/spotMicro-ROS-Melodic-Jetson-Nano/assets/15_right_link1_config_step_2.png

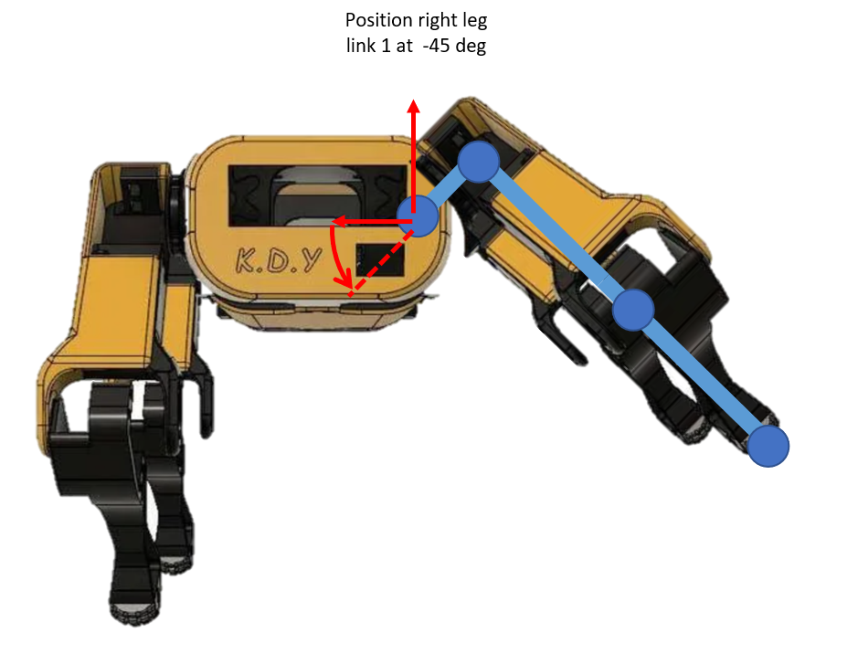
spotMicro-ROS-Melodic-Jetson-Nano/assets/15_right_link1_config_step_2.png
