DataXujing/SpotM2-Jetson/spotMicro-ROS-Melodic-Jetson-Nano/assets/16_left_link1_config_step_1.png

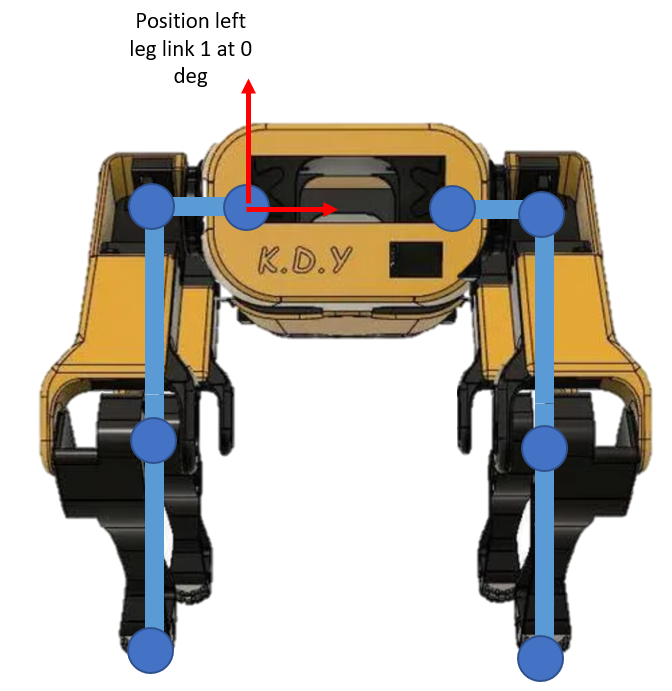
spotMicro-ROS-Melodic-Jetson-Nano/assets/16_left_link1_config_step_1.png
