DataXujing/SpotM2-Jetson/spotMicro-ROS-Melodic-Jetson-Nano/assets/17_left_link1_config_step_2.png

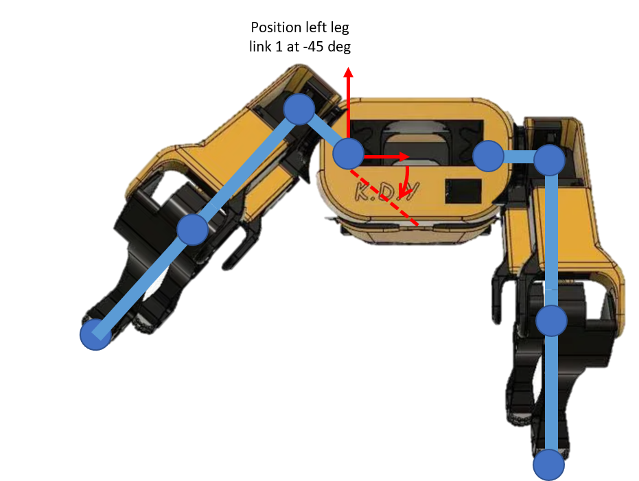
spotMicro-ROS-Melodic-Jetson-Nano/assets/17_left_link1_config_step_2.png
