DataXujing/SpotM2-Jetson/spotMicro-ROS-Melodic-Jetson-Nano/assets/custom_shoulder_assembly.jpg

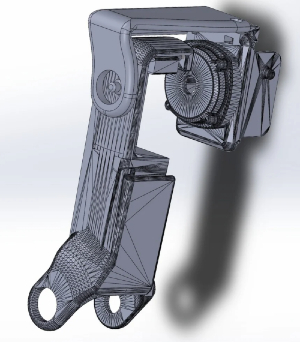
spotMicro-ROS-Melodic-Jetson-Nano/assets/custom_shoulder_assembly.jpg
