DataXujing/SpotM2-Jetson/servo_calibration_spreadsheet.ods

Servo | Position 1 PWM | Position 2 PWM | Position 1 Angle | Position 2 Angle | Slope (pwm/deg) | Center PWM Val | Calculated Angle at Center PWM Value | PWM val for negative max servo angle from center | PWM val for max servo angle from center | Range | Direction | Link Description
1 | 397 | 167 | 0 | 90 | -2.56 | 306 | 35.61 | 516.83 | 95.17 | 421.7 | -1 | Right front lower leg | Values in bold used for servo configuration
2 | 192 | 405 | 0 | -90 | -2.37 | 306 | -48.17 | 501.25 | 110.75 | 390.5 | -1 | Right front upper leg
3 | 299 | 389 | 0 | -45 | -2.00 | 306 | -3.50 | 471.00 | 141.00 | 330.0 | -1 | Right front hip
4 | 421 | 200 | 0 | 90 | -2.46 | 306 | 46.83 | 508.58 | 103.42 | 405.2 | -1 | Right back lower leg
5 | 348 | 143 | -90 | 0 | -2.28 | 306 | -71.56 | 493.92 | 118.08 | 375.8 | -1 | Right back upper leg
6 | 421 | 323 | -45 | 0 | -2.18 | 306 | 7.81 | 485.67 | 126.33 | 359.3 | -1 | Right back hip
7 | 372 | 167 | -90 | 0 | -2.28 | 306 | -61.02 | 493.92 | 118.08 | 375.8 | -1 | Left back lower leg
8 | 462 | 241 | 0 | 90 | -2.46 | 306 | 63.53 | 508.58 | 103.42 | 405.2 | -1 | Left back upper leg
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
