DataXujing/SpotM2-Jetson/deepsocial/test_img/1e55ca499b109a8f58c59cec6625aa7d.jpeg

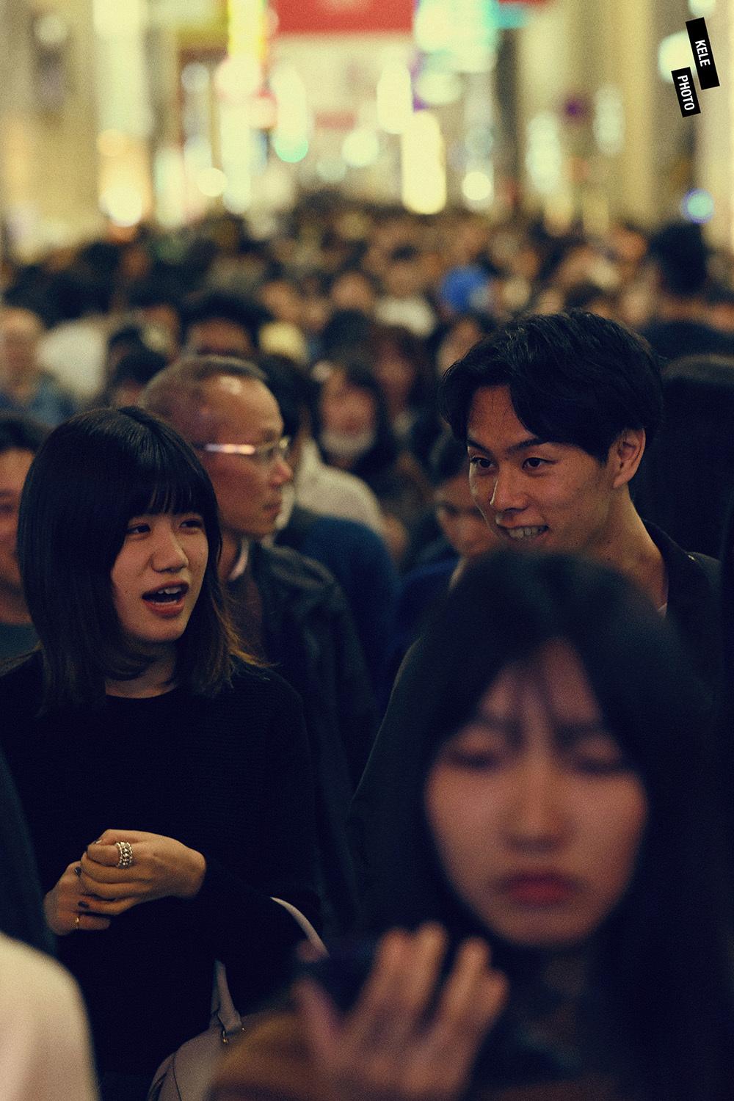
deepsocial/test_img/1e55ca499b109a8f58c59cec6625aa7d.jpeg
