DataXujing/SpotM2-Jetson/deepsocial/test_img/76a0da085213dce2dc654bfbd03b5c2e.jpeg

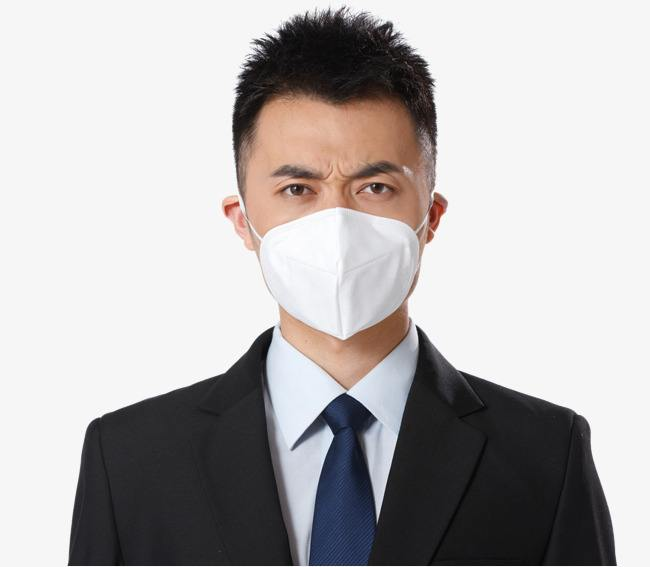
deepsocial/test_img/76a0da085213dce2dc654bfbd03b5c2e.jpeg
