DataXujing/SpotM2-Jetson/deepsocial/test_img/df1ec98a7be1bb21a3fbe03b773ce5f9.jpeg

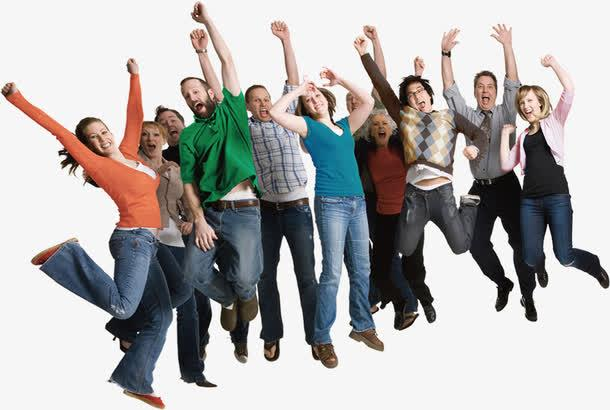
deepsocial/test_img/df1ec98a7be1bb21a3fbe03b773ce5f9.jpeg
