DataXujing/SpotM2-Jetson/deepsocial/test_img/ed89a410d687e686057929587740cf3d.jpeg

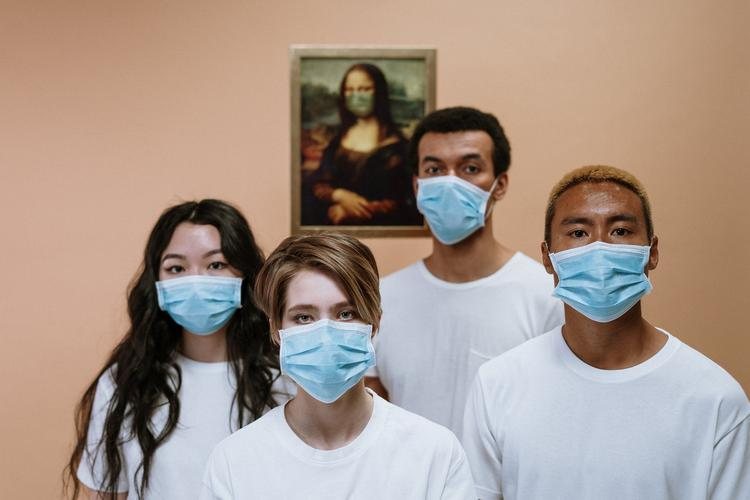
deepsocial/test_img/ed89a410d687e686057929587740cf3d.jpeg
