DataXujing/SpotM2-Jetson/spotMicro-ROS-Melodic-Jetson-Nano/assets/servo_calibration_spreadsheet.png

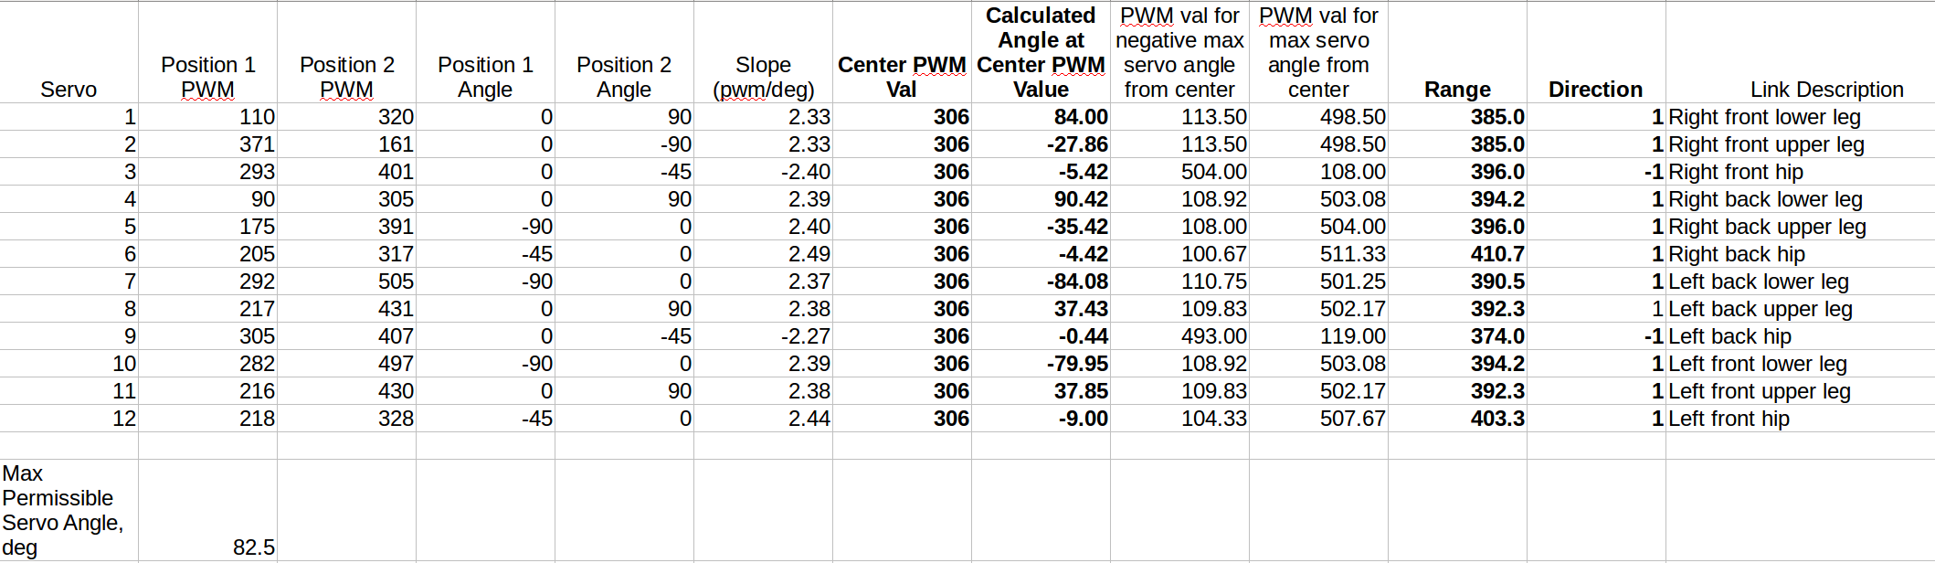
spotMicro-ROS-Melodic-Jetson-Nano/assets/servo_calibration_spreadsheet.png
